quochuymao/project232/docs/stm32f103c8t6_development_kit__3_.jpg

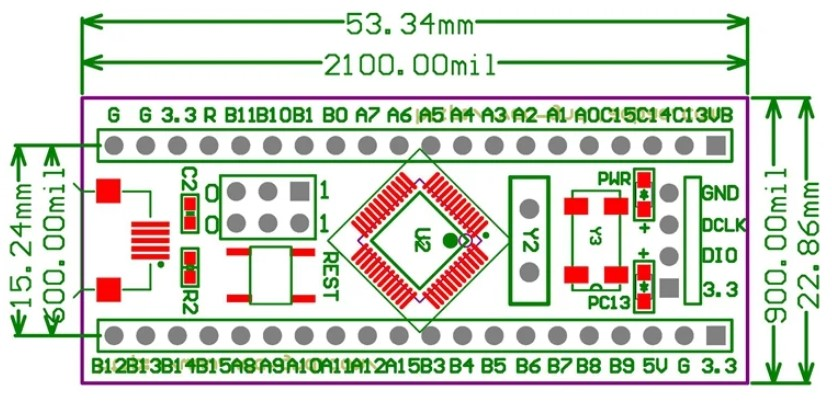
docs/stm32f103c8t6_development_kit__3_.jpg
