quochuymao/project232/project_rfs/MPPT 10A/IMG PCB.JPG

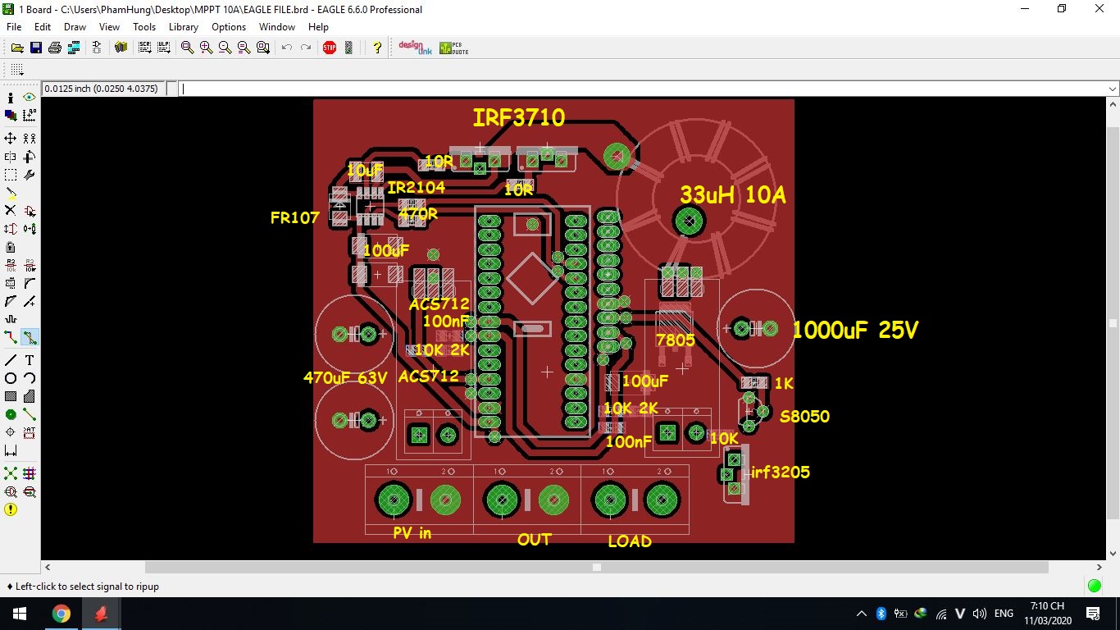
project_rfs/MPPT 10A/IMG PCB.JPG
