quochuymao/project232/project_rfs/firmware docs and API/fucntion.docx

Đọc ADC

ADC_Vi >= 17.6V → Buck_EN

ADC_Vi < 17.6 → Buck_DIS

Từ ADC_Vo và ADC_Io → P_out

Từ ADC_Vi và ADC_Ii → P_in

P_out và P_in lên LCD

LCD:

Dòng 1: Pout = Pin =

Dòng 2: Bat: (CH or NCH) LOAD: ( ON or OFF)

Duty_cycle ++ để thay đổi P_out →

So sánh P_out hiện tại với P_out trước → Lấy cái lớn hơn

ADC_Vo >11.5V → LOAD_EN

ADC_Vo < 11.5V → LOAD_DIS
