quochuymao/project232/docs/thamkhao.pdf

BỘ CÔNG THƯƠNG
TRƯỜNG ĐẠI HỌC KINH TÊ - KỸ THUẬT CÔNG NGHIỆP KHOA ĐIỆN

ĐỒ ÁN 2
THIẾT KẾ BỘ BIẾN ĐỔI DC-DC BUCK ĐỂ NẠP ACQIU TỪ PANEL PV

TÊN ĐỀ TÀI:

(Thiết kế bộ biến đổi DC-DC BUCK để nạp acqui từ PANEL PV)

Ngành đào tạo: Công nghệ kỹ thuật Điện – Điện tử

Họ và tên sinh viên: Nguyễn Cao Kỳ Lớp : D10A1 – HN
MSSV : 16104100052

Người hướng dẫn :

Hà Nội - 2019

ĐT-LVTN-02

NHẬN XÉT CỦA GIÁO VIÊN HƯỚNG DẪN

Hà Nội, Ngày …. Tháng …. Năm 2018

NHẬN XÉT CỦA GIÁO VIÊN DUYỆT

Hà Nội, Ngày …. Tháng …. Năm 2018

CHƯƠNG 1
Tổng quan về bộ biến đổi 1 chiều DC-DC
1) Tổng quan về về bộ biến đổi 1 chiều dc-dc
Ngày nay, các bộ biến đổi sử dụng trong các hệ thống rất thông dụng bởi hiệu suất va chất lượng điện áp. Các bộ biến đổi điện áp một chiều là một trong những bộ biến đổi được sử dụng nhiều nhất. Trong đó, bộ biến đổi giảm áp (Buck Converter) sẽ cho điện áp đầu ra giảm đi so với điện áp đầu vào. Nó được ứng dụng rộng rãi trong nhiều thiết bị hay hệ thống khác nhau như: cấp nguồn cho máy tính và laptop, các bộ sạc điện thoại, nạp pin từ năng lượng mặt trời… Như chúng ta đã biết thì nguồn điện là một phần rất quan trọng đối với một mạch điện hay một hệ thống điện nào đó. Nguồn điện ảnh hưởng trực tiếp đến hoạt động của mạch hay hệ thống. Đối với mỗi mạch điện hay hệ thống nó cần đòi hỏi các nguồn đầu vào khác nhau từ một nguồn đầu vào cố định hay có sẵn. Nguồn DC được sử dụng rất rộng rãi và được sử dụng hầu hết trong các mạch điện hay các hệ thống điện. Nhưng để sử dụng nguồn DC vào hệ thống của mình thì nguồn DC này cần phải được biến đổi thành nguồn DC khác hay nhiều nguồn DC cung cấp cho hệ thống. Ví dụ như mình có 1 nguồn đầu vào là 12V mà hệ thống của mình nó chạy tới 100V thì lúc này chúng ta phải biến đổi điện áp từ 12V lên 100V để chạy được hệ thống của chúng ta.
Hiện nay thì nguồn xung hay nói cách khác nó là các bộ nguồn biến đổi DC-DC nó được sử dụng phổ biến hầu hết trên các mạch điện và các hệ thống điện tự động. Với ưu điểm là khả năng cho hiệu suất đầu ra cao, tổn hao thấp, ổn định được điện áp đầu ra khi đầu vào thay đổi, cho nhiều đầu ra khi với một đầu vào....Nguồn xung hiện nay có rất nhiều loại khác nhau nhưng nó được chia thành 2 nhóm nguồn : Cách ly và không cách ly
* Nhóm nguồn không cách ly :
+ Boot
+ Buck
+ Buck - Boot
* Nhóm nguồn cách ly :
+ flyback
+ Forward
+ Push-pull

+ Half Bridge
+ .......
Mỗi loại nguồn trên đều có những ưu nhược điểm khác nhau. Nên tùy theo yêu cầu của nguồn mà ta chọn các kiểu nguồn xung như trên. Sau đây là nguyên tắc hoạt động của từng bộ nguồn trên mình chỉ nói về các bộ nguồn hay dùng trong thực tế :

### 1.1 Nguồn xung kiểu : Buck

Đây là kiểu biến đổi nguồn cho điện áp đầu ra nhỏ hơn so với điện áp đầu vào tức là Vinout
Xét một mạch nguyên lý sau :

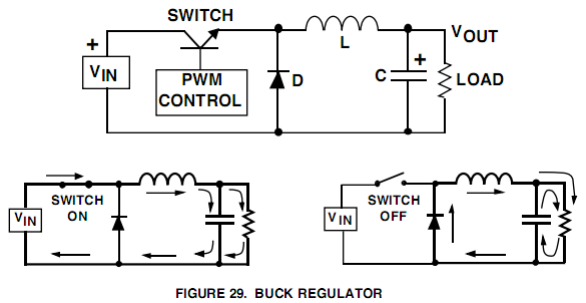
[picture p19: figure]

Mạch có cấu tạo nguyên lý đơn giản chỉ dùng một van đóng cắt nguồn điện và phần lọc đầu ra. Điện áp đầu ra được điều biến theo độ rộng xung
Khi " Switch On" được đóng tức là nối nguồn vào mạch thì lúc đó dòng điện đi qua cuộn cảm và dòng điện trong cuộn cảm tăng lên, tại thời điểm này thì tụ điện được nạp đồng thời cũng cung cấp dòng điện qua tải. Chiều dòng điện được chạy theo hình vẽ Khi " Swith Off" được mở ra tức là ngắt nguồn ra khỏi mạch. Khi đó trong cuộn cảm tích lũy năng lượng từ trường và tụ điện điện được tích lũy trước đó sẽ phóng qua tải. Cuộn cảm có xu hướng giữ cho dòng điện không đổi và giảm dần. Chiều của dòng điện trong thời điểm này như trên hình vẽ.
Quá trình đóng cắt liên tục tạo tải một điện áp trung bình theo luật băm xung PWM. Dòng điện qua tải sẽ ở dạng xung tam giác đảm bảo cho dòng liên tục qua tải. Tần số đóng cắt khá cao để đảm bảo triệt nhiễu công suất cho mạch. Van công suất thường sử dụng các van như Transitor tốc độ cao, Mosfet hay IGBT... Điện áp đầu ra đuoẹc tính như sau:

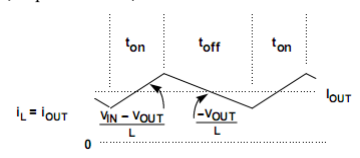
[picture p20: figure]

Vout = Vin * (ton/(ton+toff) = Vin* D ( với D là độ rộng xung %)
Với ton, toff lần lượt là thời gian mở và thời gian khóa của van
Đối với kiểu nguồn Buck này thì cho công suất đầu ra rất lớn so với công suất đầu vào vì sử dụng cuộn cảm, tổn hao công suất thấp. Do vậy nên nguồn buck được sử dụng nhiều trong các mạch giảm áp nguồn DC. ví dụ như từ điện áp 17V DC mà muốn hạ xuống 12V DC thì dùng nguồn Buck là hợp lý.

### 1.2 Nguồn xung kiểu : Boot

Kiểu dạng nguồn xung này cho điện áp đầu ra lớn hơn điện áp đầu vào : Vin < Vout
Xét một mạch nguyên lý như sau :

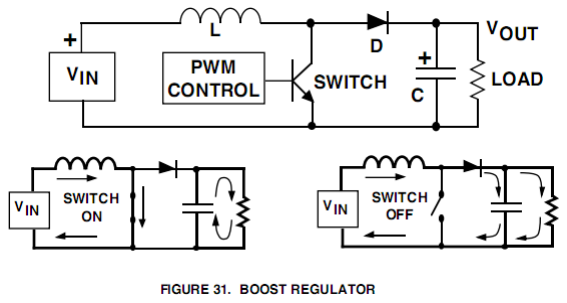
[picture p21: figure]

Mạch có cấu tạo nguyên lý khá đơn giản. Cũng dùng một nguồn đóng cắt, dùng cuộn cảm và tụ điện. Điện áp đầu ra phụ thuộc vào điều biến độ rộng xung và giá trị cuộn cảm L

Khi “Swich On” được đóng lại thì dòng điện trong cuộn cảm được tăng lên rất nhanh, dòng điện sẽ qua cuộn cảm qua van và xuống đất. Dòng điện không qua diode và tụ điện phóng điện cung cấp cho tải. Ở thời điểm này thì tải được cung cấp bởi tụ điện. Chiều của dòng điện như trên hình vẽ
Khi “Switch Off” được mở ra thì lúc này ở cuối cuộn dây xuất hiện với 1 điện áp bằng điện áp đầu vào. Điện áp đầu vào cùng với điện áp ở cuộn cảm qua diode cấp cho tải và đồng thời nạp cho tụ điện. Khi đó điện áp đầu ra sẽ lớn hơn điện áp đầu vào, dòng qua tải được cấp bởi điện áp đầu vào. Chiều của dòng điện được đi như hình vẽ!

Điện áp ra tải còn phụ thuộc giá trị của cuộn cảm tích lũy năng lượng và điều biến độ rộng xung (điều khiển thời gian on/off). Tần số đóng cắt van là khá cao hàng Khz để triệt nhiễu công suất và tăng công suất đầu ra.Dòng qua van đóng cắt nhỏ hơn dòng đầu ra.Van công suất thường là Transior tốc độ cao, Mosfet hay IGBT… Diode là diode xung, công suất
Công thức tính các thông số đầu ra của nguồn Boot như sau :

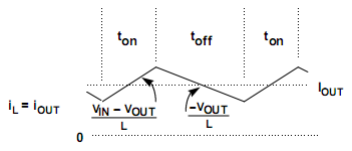
[picture p22: figure]

Ipk = 2 x Iout,max x (Vout / Vin,min) Tdon = (L x Ipk) / (Vout – Vin)
Điện áp đầu ra được tính như sau :

Vout = ((Ton / Tdon) + 1) x Vin
Với : Ton là thời gian mở của Van
Ipk là dòng điện đỉnh
Trong nguồn Boot thì điện áp đầu ra lớn hơn so với điện áp đầu vào do đó công suất đầu vào phải lớn hơn so vói công suất đầu ra. Công suất đầu ra phụ thuộc vào cuộn cảm L.Hiệu suất của nguồn Boot cũng khá cao nên được dùng nhiều trong các mạch nâng áp do nó truyền trực tiếp nên công suất của nó rất lớn. Ví dụ như mạch biến đổi từ nguồn 12VDC lên 310VDC chả hạn.
Nguồn Boot có 2 chế độ:

– Chế độ không liên tục: Nếu điện cảm của cuộn cảm quá nhỏ, thì trong một chu kỳ đóng cắt, dòng điện sẽ tăng dần nạp năng lượng cho điện cảm rồi giảm dần, phóng năng lượng từ điện cảm sang tải. Vì điện cảm nhỏ nên năng lượng trong điện cảm cũng nhỏ, nên hết một chu kỳ, thì năng lượng trong điện cảm cũng giảm đến 0. Tức là trong một chu kỳ dòng điện sẽ tăng từ 0 đễn max rồi giảm về 0.
– Chế độ liên tục: Nếu điện cảm rất lớn, thì dòng điện trong 1 chu kỳ điện cảm sẽ không thay đổi nhiều mà chỉ dao động quanh giá trị trung bình.Chế độ liên tục có hiệu suất và chất lượng bộ nguồn tốt hơn nhiều chế độ không liên tục, nhưng đòi hỏi cuộn cảm có giá trị lớn hơn nhiều lần.

### 1.3 NGUỒN XUNG KIỂU FLYBACK

Đây là kiểu nguồn xung truyền công suất dán tiếp thông qua biến áp. Cho điện áp đầu ra lớn hơn hay nhỏ hơn điện áp đầu vào. Từ một đầu vào có thể cho nhiều điện áp đầu ra
Sơ đồ nguyên lý như sau :

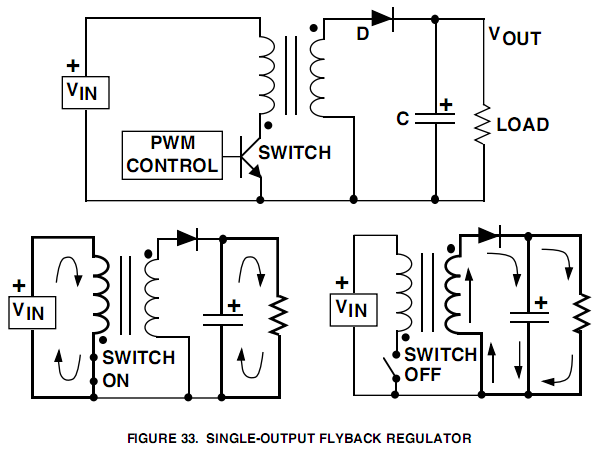
[picture p23: figure]

Mạch có cấu tạo bởi 1 van đóng cắt và 1 biến áp xung. Biến áp dùng để truyền công suất từ đầu vào cho đầu ra. Điện áp đầu ra phụ thuộc vào băm xung PWM và tỉ số truyền của lõi

Như chúng ta đã biết chỉ có dòng điện biến thiên mới tạo được ra từ thông và tạo được ra sức điện động cảm ứng trên các cuộn dây trên biến áp. Do đây là điện áp một chiều nên dòng điện không biến thiên theo thời gian do đó ta phải dùng van đóng cắt liên tục để tạo ra được từ thông biến thiên.
Khi “Switch on ” được đóng thì dòng điện trong cuộn dây sơ cấp tăng dần lên. Cực tính của cuộn dây sơ cấp có chiều như hình vẽ và khi đó bên cuộn dây thứ cấp sinh ra một điện áp có cực tính dương như hình vẽ. Điện áp ở sơ cấp phụ thuộc bởi tỷ số giữa cuộn dây sơ cấp và thứ cấp. Lúc này do diode chặn nên tải được cung cấp bởi tụ C
Khi “Switch Off” được mở ra. Cuộn dây sơ cấp mất điện đột ngột lúc đó bên thứ cấp đảo chiều điện áp qua Diode cung cấp cho tải và đồng thời nạp điện cho tụ
Trong các mô hình của nguồn xung thì nguồn Flybach được sử dụng nhiều nhất bởi tính linh hoạt của nó, cho phép thiết kế được nhiều nguồn đầu ra với 1 nguồn đầu vào duy nhất kể cả đảo chiều cực tính. Các bộ biến đổi kiểu Flyback được sử dụng rộng rãi trong các hệ thống sử dụng nguồn pin hoặc acqui, có một nguồn điện áp vào duy nhất để cung cấp cho hệ thống cần nhiều cấp điện áp(+5V,+12V,-12V) với hiệu suất chuyển đổi cao.Đặc điểm quan trọng của bộ biến đổi Flyback là pha(cực tính) của biến áp xung được biểu diễn bởi các dấu chấm trên các cuộn sơ cấp và thứ cấp (trên hình vẽ)
Công thức tính toán cho nguồn dùng Flyback

Vout=Vin x (n2/n1) x (Ton x f) x (1/(1-(Ton x f)))
với :
- n2 = cuộn dây thứ cấp của biến áp
- n1 = Cuộn dây sơ cấp biến áp
- Ton = thời gian mở của Q1 trong 1 chu kì
- f là tần số băm xung (T=1/f = (Ton + Toff))
Nguồn xung kiểu Flyback hoạt động ở 2 chế độ : Chế độ liên tục (dòng qua thứ cấp luôn > 0) và chế độ gián đoạn (dòng qua thức cấp luôn bằng 0)

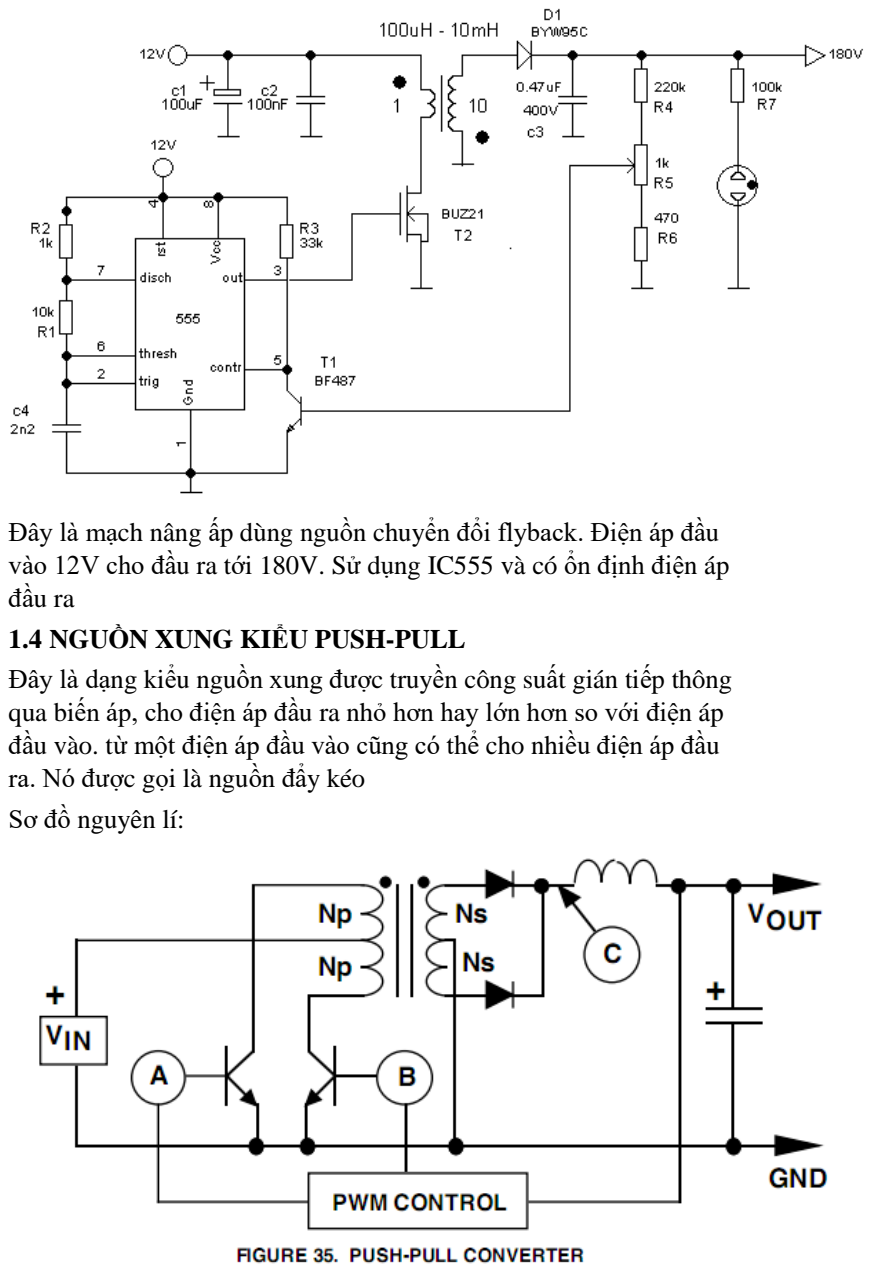
[picture p24: page 10]

Đây là mạch nâng ấp dùng nguồn chuyển đổi flyback. Điện áp đầu vào 12V cho đầu ra tới 180V. Sử dụng IC555 và có ổn định điện áp đầu ra

### 1.4 NGUỒN XUNG KIỂU PUSH-PULL

Đây là dạng kiểu nguồn xung được truyền công suất gián tiếp thông qua biến áp, cho điện áp đầu ra nhỏ hơn hay lớn hơn so với điện áp đầu vào. từ một điện áp đầu vào cũng có thể cho nhiều điện áp đầu ra. Nó được gọi là nguồn đẩy kéo
Sơ đồ nguyên lí:

Đối với nguồn xung loại Push-Pull này thì dùng tới 2 van để đóng cắt biến áp xung và mỗi van dẫn trong 1 nửa chu kì. Nguyên tắc cũng gần giống với nguồn flyback
Khi A được mở B đóng thì cuộn dây Np ở phía trên sơ cấp có điện đồng thời cảm ứng sang cuộn dây Ns phía trên ở thứ cấp có điện và điện áp sinh ra có cùng cực tính. Dòng điện bên thứ cấp qua Diode cấp cho tải. Như trên hình vẽ
Khi B mở và A đóng thì cuộn dây Np ở phía dưới sơ cấp có điện đồng thời cảm ứng sang cuộn dây Ns phía dưới thứ cấp có điện và điện áp này sinh ra cũng cùng cực tính. Như trên hình vẽ.
Với việc đóng cắt liên tục hai van này thì luôn luôn xuất hiện dòng điện liên tục trên tải. Chính vì ưu điểm này mà nguồn Push Pull cho hiệu suất biến đổi là cao nhất và được dùng nhiều trong các bộ nguồn như UPS, Inverter…
Công thức tính cho nguồn Push-pull

Vout = (Vin/2) x (n2/n1) x f x (Ton,A + Ton,B)
Với :
- Vout=Điện áp đầu ra -V
- Vin= Điện áp đầu vào – Volts
- n2=0.5 x cuộn dây thứ cấp. Tức là cuộn dây thứ cấp sẽ quấn sau đó chia 1/2. Đợn vị tính bằng Vòng
- n1=Cuộn dây sơ cấp
- f = Tần số đóng cắt – Hertz
- Ton,A = thời gian mở Van A – Seconds
- Ton,B = Thời gian mở Van B – Seconds

CHƯƠNG 2: CHỌN VÀ PHÂN TÍCH MẠCH LỰC

2) Cấu trúc mạch lực:

Cấu trúc vòng điều khiển điện áp của mạch có dạng chung như sau:

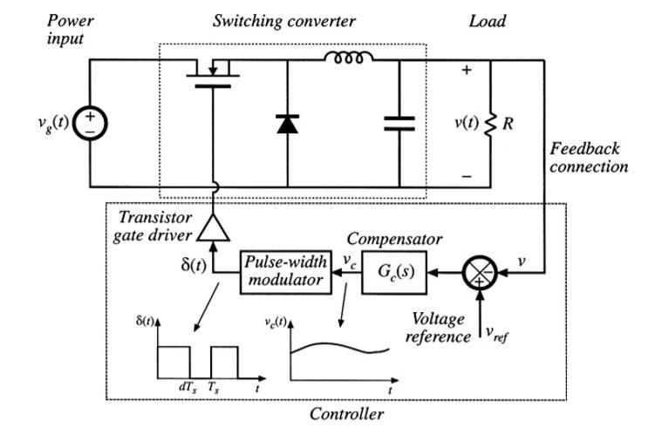
[picture p25: figure]

2.1) Tính toán các thông số cơ bản: Các yêu cầu thiết kế:
- Vin = 17 V
- Vout = 12V
- ILoad = 2A
- fsw= 100kHz ( tần số chuyển mạch)
- Iripple = 0.3 × IL
1. Trình bày cấu trúc mạch lực và nguyên tắc phát xung điều khiển.
2. Tính chọn giá trị danh định và lựa chọn cụ thể (nhà SX, mã sản phẩm) tất cả các phần tử trong mạch: Van bán dẫn, tụ điện, điện cảm,… theo các thông số kỹ thuật yêu cầu.
3. Xây dựng chương trình mô phỏng bộ biến đổi kiểm chứng thiết kế.
2.1.1.Tính toán cuộn cảm L

Khi van ở trạng thái ON thì diện áp trên ahi đầu cuộn cảm bằng [1]: vL(t) = Vg - v(t)
Hay gần đúng sẽ là:
vL(t) = Vg – V | (2.2)
Trong đó vL tính theo công thức:
vL = LdiL(t) dt | (2.3)

Từ đó ta được:
diL(t)
dt

=

vL(t)
L

≈

Vg−V
L

(2.4)

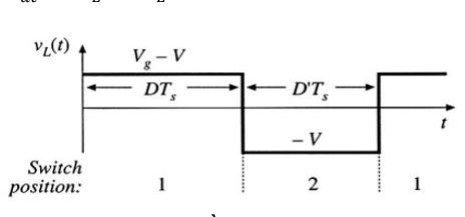
[picture p26: figure]

Hình 2.2 Đồ thị điện áp trên cuộn cảm theo thời gian

Khi van ở trạng thái mở thì điện áp cuộn cảm bằng: vL

(t) = −v(t) | (2.5)
Với v(t) ≈ V thì:
vL
(t) = −V | (2.6)
Suy ra :
diL(t)
dt

= −

V L | (2.7)

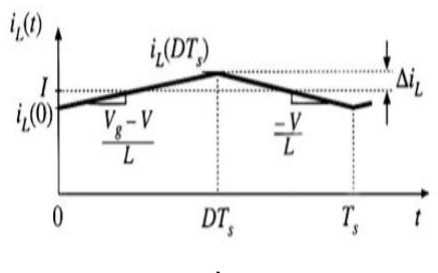
[picture p27: figure]

Hình 2.3 Đồ thị dòng điện qua cuộn cảm theo thời gian

Dòng điện qua cuộn cảm được miêu tả như Hình 2.3, ta có thể thấy

dòng điện Ipeak = I + ∆iL

, trong đó ∆iL
là độ gợn (độ dao động)
của dòng điện qua cuộn cảm.
Nên độ gợn peak-to-peak sẽ là 2∆iL và bằng : 2∆iL =

Vg−V
L

DTs
(2.8)
Suy ra:

L = Vg−V
2∆iL

DTs
(2.9)
Với giá trị ∆iL

thường được chọn khoảng 10 ÷ 20%Iout. Ta chọn: ∆iL = 10%Iout = 0,2A Hệ số đóng cắt của van đóng cắt: D = V
Vg

=

12
17
= 0,7 | (2.10)
Thay các thông số từ yêu cầu vào L = Vg−V
2∆iL

DTs
(2.9), ta tính được

giá tri cuộn cảm như sau:
L = Vg−V
2∆iL

DTs =

17−12
2.0,2.100.10³
.0,7 = 87µF | (2.11)

### 2.1.2 Tính toán tụ C đầu ra

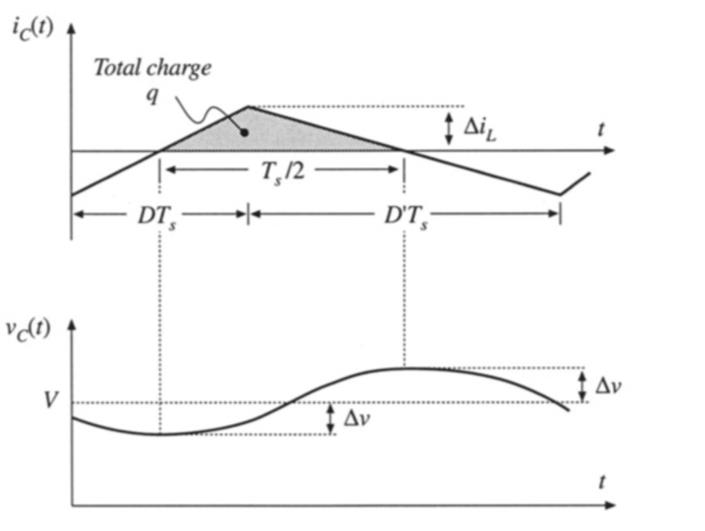
[picture p28: figure]

Hình 2.4 Dòng điện và điện áp trên tụ [6]

a) Tính toán giá trị điện dung C của tụ điện Lượng điện tích trong tụ được tính theo công thức [1]:
(change in charge) = C. (change in voltage) (2.12)
Hinh 2.4 mô tả hình dạng dòng điện và điện áp trên tụ, từ đó ta có:

q = C(2∆v) | (2.13)
hay:

q =

1
2

V. ∆iL

Ts
2

(2.14)

Từ q = C(2∆v) (2.13) hay: q =

1
2

V. ∆iL

Ts
2

(2.14), ta được:

∆v =

∆iL.Ts
8C

(2.15)

Suy ra :

C = ∆iL.Ts
8∆v

(2.16)

Chọn độ dao động điện áp: ∆v = 1%V = 1%.12 = 0,12 V Thay các thông số từ yêu cầu vào Suy ra: C = ∆iL.Ts
8∆v

(2.16), ta
tính được giá trị điện dung của tụ điện như sau :

C=∆iL.Ts
8∆v

=

1
8.0.0,12.100.10³

≈ 10uF

Chọn tụ điện theo catologe của nhà sản xuất: C = 4700 µF (chọn theo kinh nghiệm)
a) Tính toán điện trở RESR của tụ điện
Sau khi tính toán và chọn được tụ điện C, dựa vao datasheet ta có thể xác định được điện trở RESR của tụ điện [2]:

Với fs = 100 khz và RESR0

là điện trở đo tại nhiệt độ 20⁰C ở tần số 100 Hz. Từ đồ thị trên datasheet (hình 2.5), ta có thể xác định được tỉ

số giữa RESR và RESR0
khoảng 0,77.
Tra bảng datasheet (bảng 2.1), ta có RESR0

= 0,10Ω => RESR
≅ 0,0789Ω.

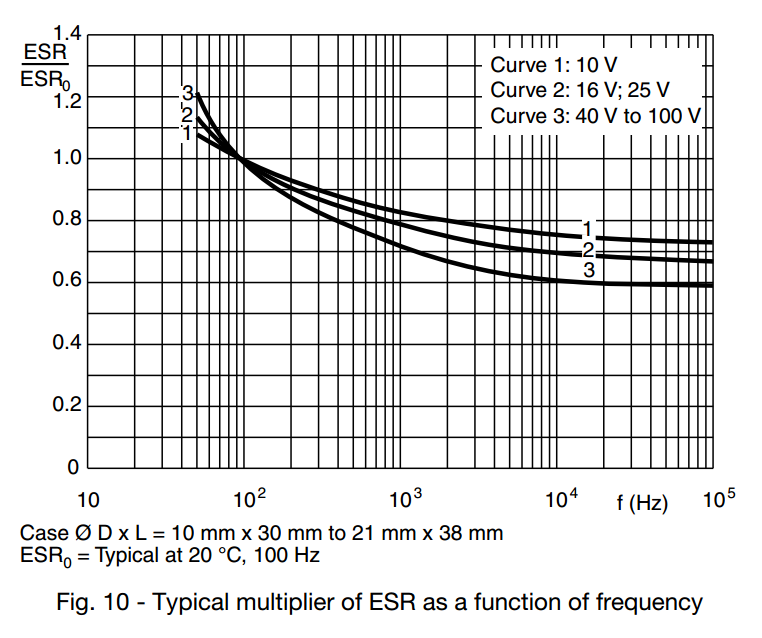
[picture p29: figure]

Hình 2.5 Đồ thị thể hiện mối liên hệ giữa điện trở và tần số của tụ điện C [2]

CR 100 Hz (µF) | NOMIAL CASE SIZE Ø D x L (mm) | CASE CODE | IR 100 Hz 125˚C (mA) | IL1 1 min (µA) | IL5 5 min (µA) | tan δ 100 Hz | ESR 100 Hz (Ω)
100 220 470 470 680 1000 1500 2200 3300 4700 | 6.5 x 18 10 x 18 10 x 25 12.5 x 30 12.5 x 30 15 x 30 18 x 30 18 x 30 18 x 38 21 x 38 | 4 6 7 01 01 02 03 03 04 05 | 130 240 380 550 640 830 1100 1190 1550 1700 | 10 17 32 32 45 64 94 136 202 286 | 6 8.4 13 13 18 24 34 48 70 90 | 0.20 0.18 0.18 0.16 0.20 0.20 0.22 0.26 0.27 0.30 | 3.50 1.30 0.61 0,54 0,47 0.32 0.23 0.19 0.13 0.10

Bảng 2.1 Bảng tra datasheet về tụ điện [2]

2.1.3 . Chọn van bán dẫn

a) Van đóng cắt

chọn van đóng cắt là MOSFET tần số cao . Dòng IL=Iout=1A nên chọn MOSFET Ì540N

có thể chịu đựng dòng tối đa là 33A , điện áp tối đa là 100V.

b) Diode
Chọn loại diode tần số cao Schottky SB540 chịu được dòng 5A và điện áp 40V.

### 2.1.4. Thiết kế cuộn cảm dung phương pháp Kg[1]

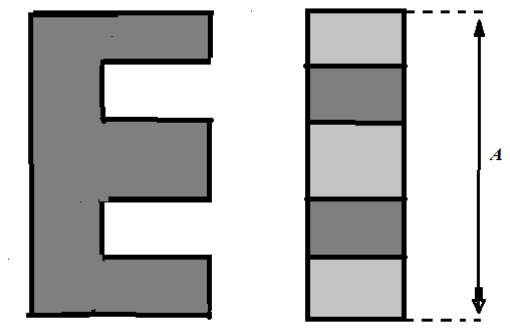
[picture p30: figure]

Hình 2.6 Hình dạng lõi thép của cuộn kháng

Với L = 87µH như đã tính toán ở trên

Tính toán hệ số Kg:

Kg ≥

ρL

2
Imax

2

Bmax

2

. 10⁸

(cm⁵
) | (2.18)

Giả sử :R=1Ω.

Với các thông số : ρ = 1,724.10⁶ (chọn dây đồng)

Imax =2A

Bmax =0,25 T

Ku =0,6

Thay vào Kg ≥

ρL

2
Imax

2

Bmax

2 RKu

. 10⁸
(cm⁵
) (2.18)

Kg ≥

1.724.10⁻⁶

.(56.10⁻⁶
)

2
.2

2
0.25².1.0,6

ta được :Kg≈ 1,39818.10⁻³

Dựa vào Bảng 2.2 Bảng chọn lõi thép , chọn lại giá trị Kg = 1,39818.10⁻³ và

chọn lõi thép EE19 có các thong số như sau:

Diện tích mặt cắt trụ giữa: Ac = 0,19 cm²

Diện tích cửa sổ: WA = 0,19 cm²

Độ dài trung bình 1 vòng dây: MLT =3,4 cm

Hệ số từ thẩm: µ0 = 4π.10⁻⁷ H/m

Bảng 2.2.Bảng chọn lõi thép

Core type

(A)

(mm)

Geometri
cal
constant

Kg

cm⁵

Geometri
cal
constant

Kgfe

cmx

Cross-section
al area

Ac

(cm²
)

Bobbi
n
windi
ng
area

WA

(cm²
)

Mea
n
lengt
h per
turn

MLT

(cm)

Magnet
ic path
length

lm

Core
weig
ht

(g)

EE12

EE16

EE19

EE22

EE30

EE40

EE50

EE60

EE70/68/
19

0.731.10⁻³

2.02.10⁻³

4.07.10⁻³

8.26.10⁻³

85.7.10⁻³

0.209

0.909

1.38

5.06

0.458.10⁻³

0.842.10⁻³

1.3.10⁻³

1.8.10⁻³

6.7.10⁻³

11.8.10⁻³

28.4.10⁻³

36.4.10⁻³

127.10⁻³

0.14

0.19

0.23

0.41

1.09

1.27

2.26

2.47

3.24

0.085

0.190

0.284

0.196

0.476

1.10

1.78

2.89

6.75

2.28

3.40

3.69

3.99

6.60

8.50

10.0

12.8

14.0

2.7

3.45

3.94

3.96

5.77

7.70

9.58

11.0

9.0

2.34

3.29

4.83

8.81

32.4

50.3

116

135

280
