quochuymao/project232/docs/LQFP48.jpg

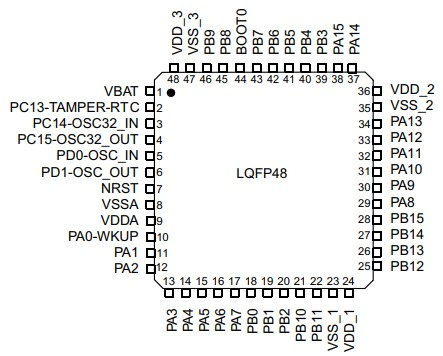
docs/LQFP48.jpg
