quochuymao/project232/project_rfs/MPPT 10A/code-simulation-on-proteus.png

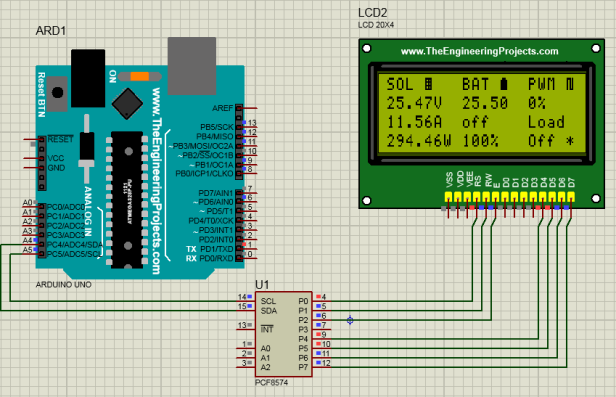
project_rfs/MPPT 10A/code-simulation-on-proteus.png
