quochuymao/project232/project_rfs/MPPT 10A/final.jpg

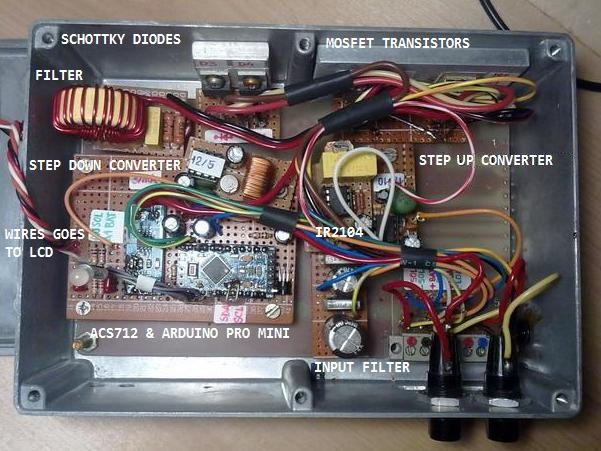
project_rfs/MPPT 10A/final.jpg
