quochuymao/project232/project_rfs/MPPT 10A/microcontrolere.wordpress_files/boost-convertor.jpg

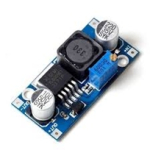
project_rfs/MPPT 10A/microcontrolere.wordpress_files/boost-convertor.jpg
