quochuymao/project232/project_rfs/MPPT 10A/microcontrolere.wordpress_files/half-bridge.jpg

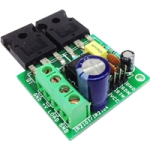
project_rfs/MPPT 10A/microcontrolere.wordpress_files/half-bridge.jpg
