quochuymao/project232/project_rfs/MPPT 10A/microcontrolere.wordpress_files/lcd111.jpg

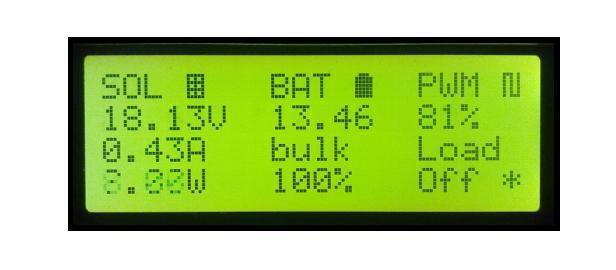
project_rfs/MPPT 10A/microcontrolere.wordpress_files/lcd111.jpg
