quochuymao/project232/project_rfs/MPPT 10A/microcontrolere.wordpress_files/oputput-current-versions.png

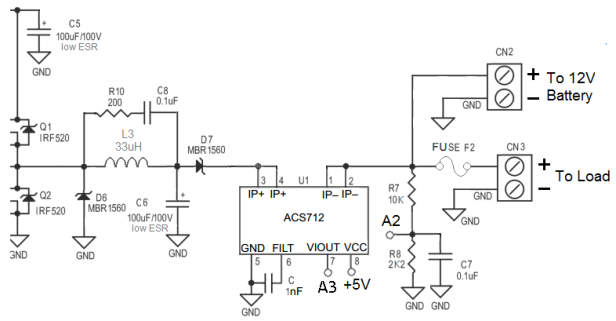
project_rfs/MPPT 10A/microcontrolere.wordpress_files/oputput-current-versions.png
