quochuymao/project232/project_rfs/MPPT 10A/microcontrolere.wordpress_files/oscilloscope.jpg

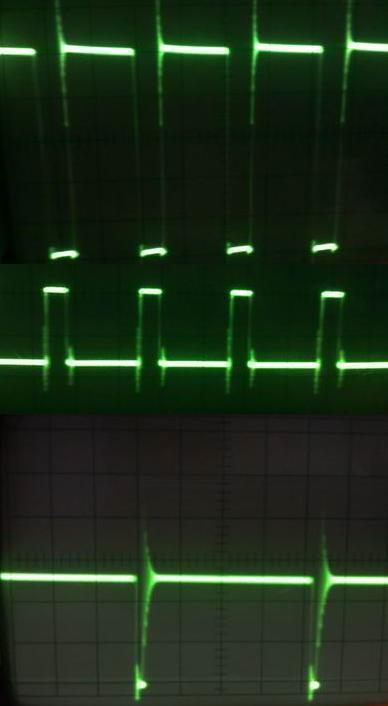
project_rfs/MPPT 10A/microcontrolere.wordpress_files/oscilloscope.jpg
