quochuymao/project232/project_rfs/MPPT 10A/microcontrolere.wordpress_files/schema-3-1.png

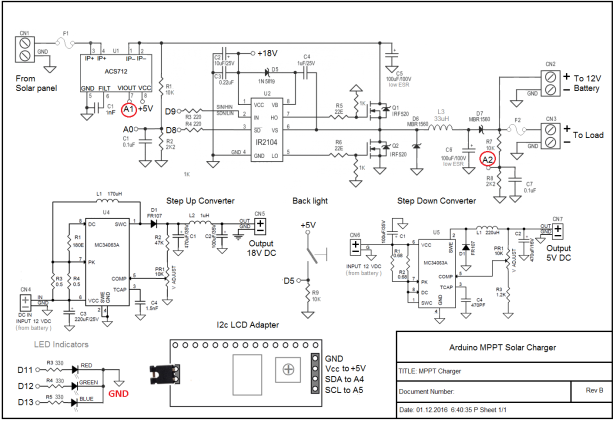
project_rfs/MPPT 10A/microcontrolere.wordpress_files/schema-3-1.png
