quochuymao/project232/project_rfs/MPPT 10A/microcontrolere.wordpress_files/simulation.png

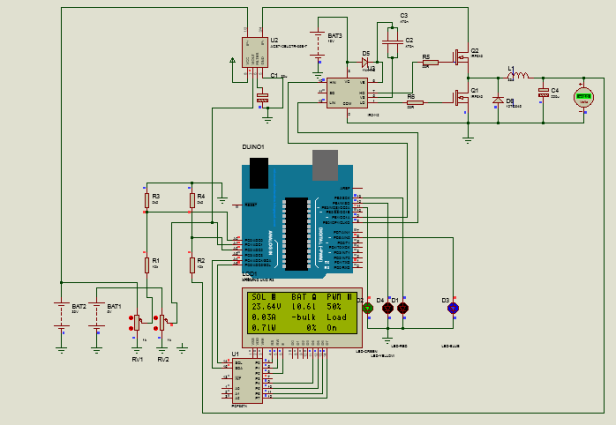
project_rfs/MPPT 10A/microcontrolere.wordpress_files/simulation.png
