quochuymao/project232/project_rfs/MPPT 10A/microcontrolere.wordpress_files/solar-charger-jpg.png

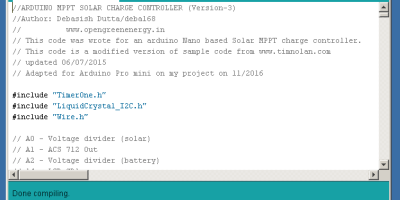
project_rfs/MPPT 10A/microcontrolere.wordpress_files/solar-charger-jpg.png
