quochuymao/project232/project_rfs/MPPT 10A/microcontrolere.wordpress_files/sym.png

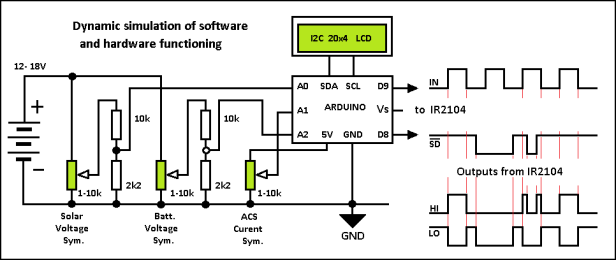
project_rfs/MPPT 10A/microcontrolere.wordpress_files/sym.png
