quochuymao/project232/project_rfs/MPPT 10A/mppt.jpg

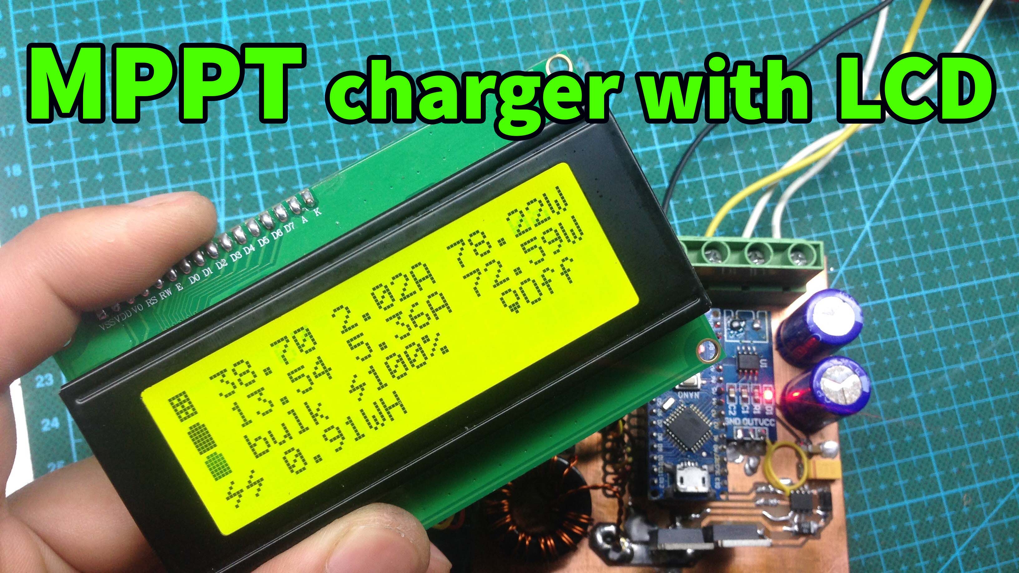
project_rfs/MPPT 10A/mppt.jpg
