quochuymao/project232/project_rfs/MPPT 10A/source.JPG

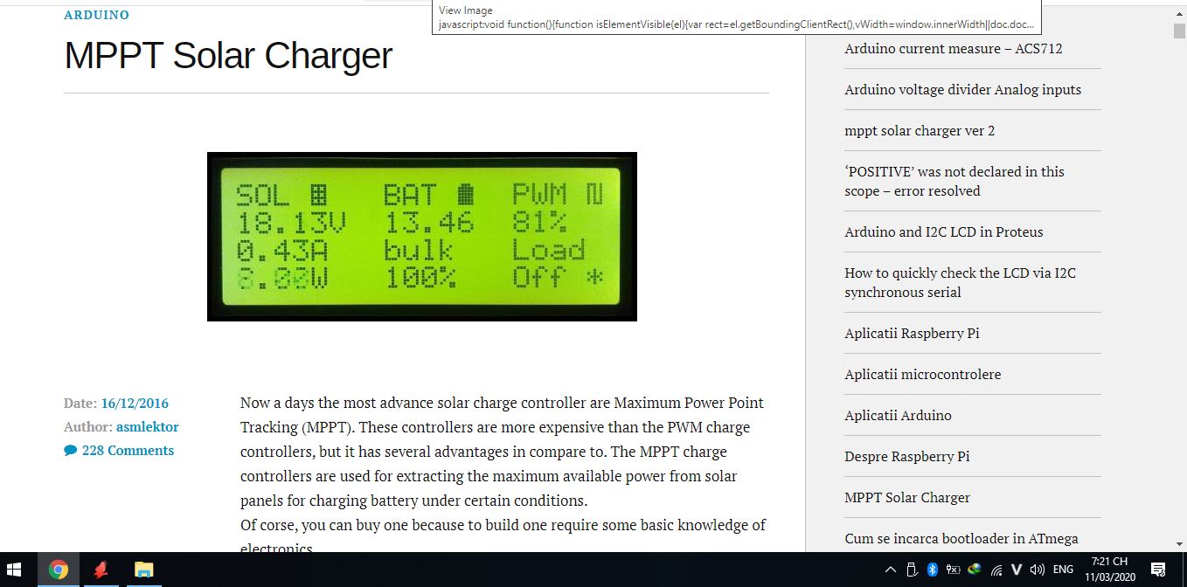
project_rfs/MPPT 10A/source.JPG
