quochuymao/project232/project_rfs/MPPT 10A/Schematic.pdf

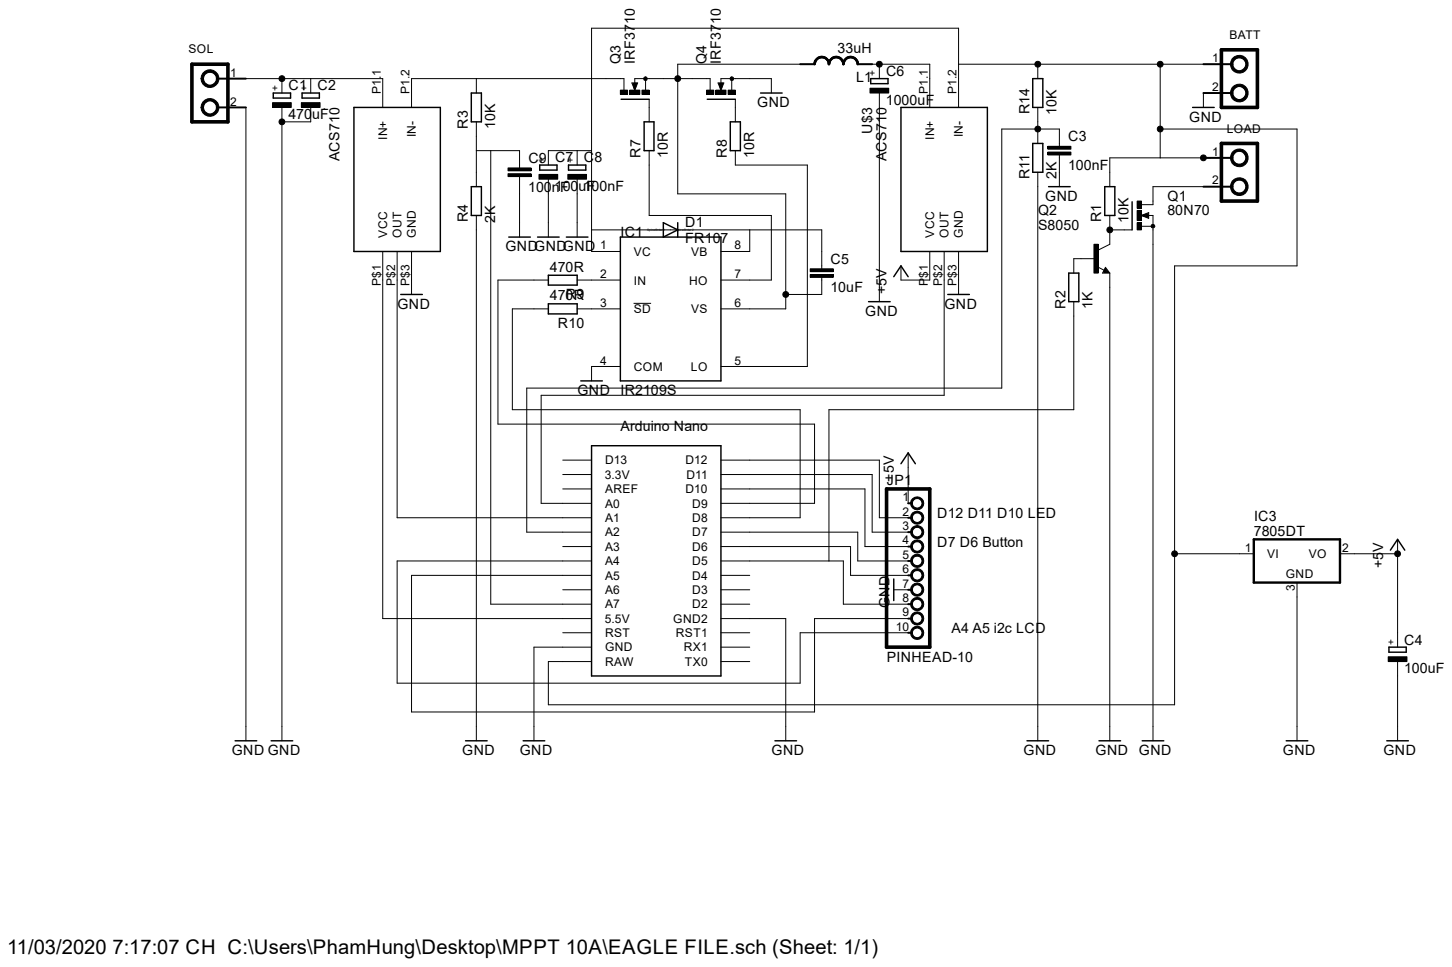
[picture p51: page 1]

11/03/2020 7:17:07 CH C:\Users\PhamHung\Desktop\MPPT 10A\EAGLE FILE.sch (Sheet: 1/1)
