quochuymao/project232/project_rfs/MPPT 10A/File PCB BOTTOM.pdf

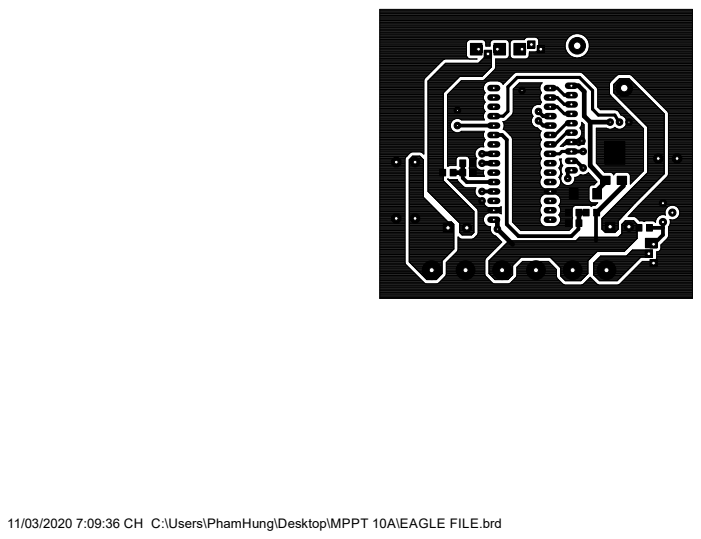
[picture p52: page 1]

11/03/2020 7:09:36 CH C:\Users\PhamHung\Desktop\MPPT 10A\EAGLE FILE.brd
