quochuymao/project232/project_rfs/MPPT 10A/File PCB TOP.pdf

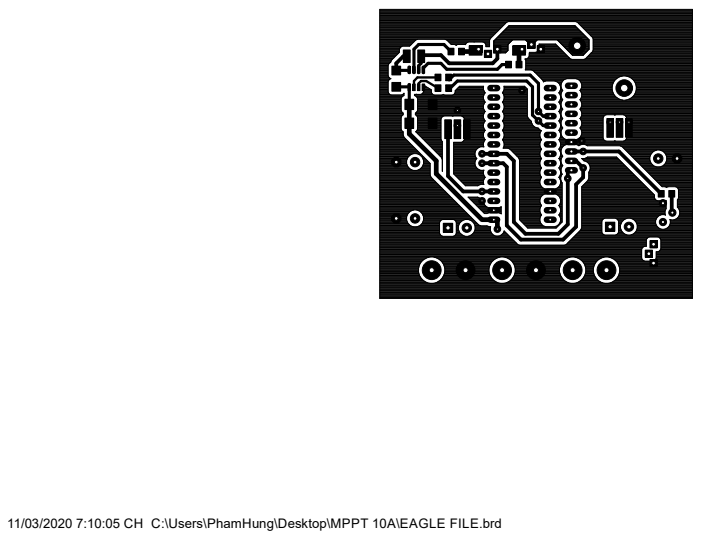
[picture p53: page 1]

11/03/2020 7:10:05 CH C:\Users\PhamHung\Desktop\MPPT 10A\EAGLE FILE.brd
