quochuymao/project232/PCB/Project232_V2/Project232_V2/Project232_V2.kicad_pcb

## KiCad design PCB/Project232_V2/Project232_V2/Project232_V2.kicad_pcb (2024-05-15, an earlier design)

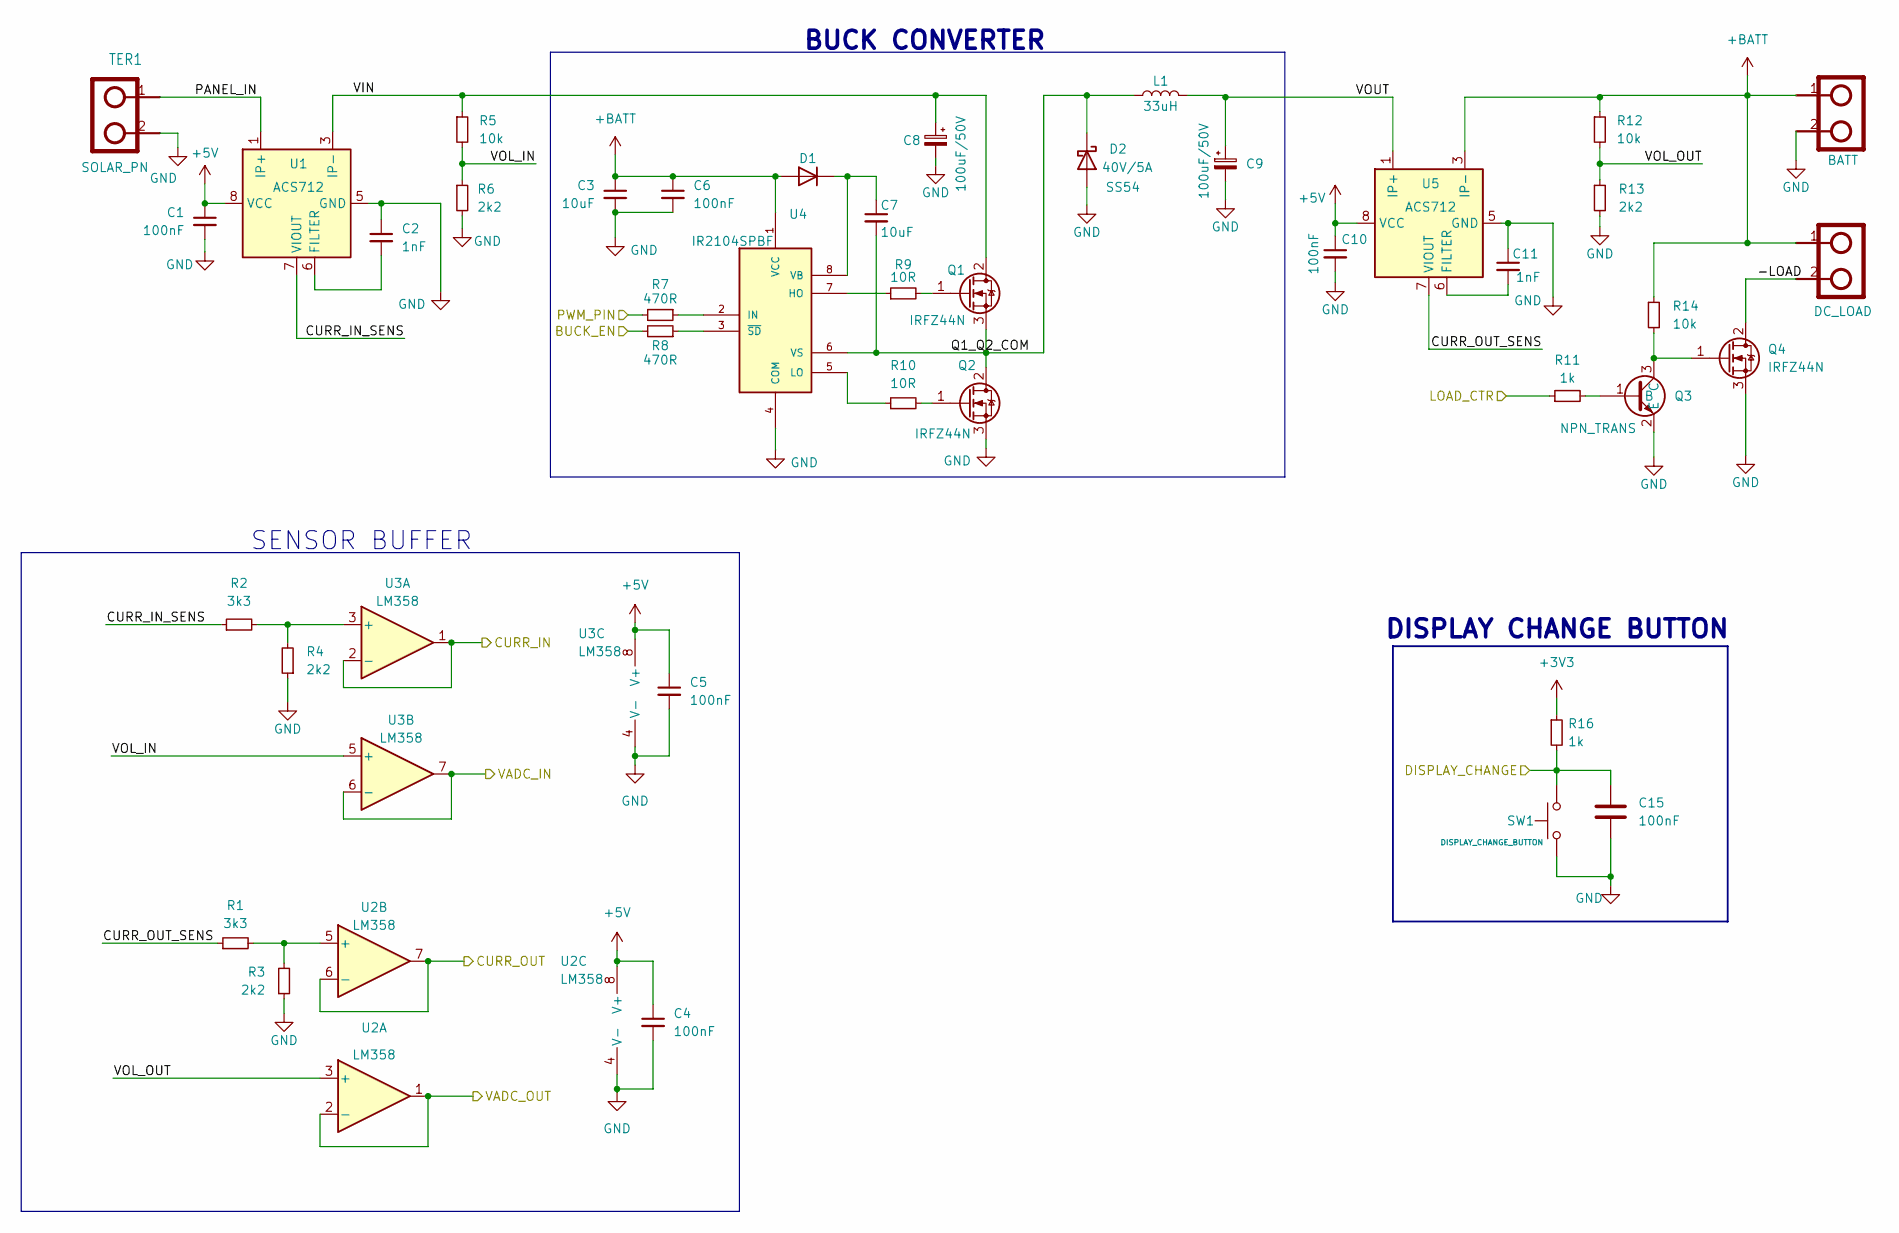
[picture p54: schematic sensor.kicad_sch]

Parts:
C1, C4, C5, C6, C10, C15: 100nF; C_0805_2012Metric
C2, C11: 1nF; C_0805_2012Metric
C3, C7: 10uF; C_0805_2012Metric
C8, C9: 100uF/50V; CP_Elec_8x10.5
D1: 1N5819W; D_SOD-123
D2: 40V/5A; D_SMC
L1: 33uH; Inductor_33uH_5A_THT
Q1, Q2, Q4: IRFZ44N; TO-220-3_Vertical
Q3: NPN_TRANS; SOT-23
R1, R2: 3k3; R_0603_1608Metric
R3, R4, R6, R13: 2k2; R_0603_1608Metric
R5, R12, R14: 10k; R_0603_1608Metric
R7, R8: 470R; R_0603_1608Metric
R9, R10: 10R; R_0603_1608Metric
R11, R16: 1k; R_0603_1608Metric
SW1: DISPLAY_CHANGE_BUTTON; Button_3x6_SMD
TER1: SOLAR_PN; TerminalBlock_bornier-2_P5.08mm
TER2: BATT; TerminalBlock_bornier-2_P5.08mm
TER3: DC_LOAD; TerminalBlock_bornier-2_P5.08mm
U1, U5: ACS712; SOIC-8_3.9x4.9mm_P1.27mm
U2, U3: LM358; SOIC-8_3.9x4.9mm_P1.27mm
U4: IR2104SPBF; SOIC127P600X175-8N; MPN IR2104SPBF

Connections:
+3V3: R16.1; also elsewhere on the board
+5V: C1.1, C4.1, C5.1, C10.1, U1.8 (VCC), U2.8 (V+), U3.8 (V+), U5.8 (VCC); also elsewhere on the board
+BATT: C3.1, C6.1, D1.2 (A), R12.1, R14.1, TER2.1, TER3.1, U4.1 (VCC), U5.3 (IP-), U5.4 (IP-); also elsewhere on the board
/MCU/BUCK_EN: R8.2; also elsewhere on the board
/MCU/CURR_IN: U3.1, U3.2 (-); also elsewhere on the board
/MCU/CURR_OUT: U2.6 (-), U2.7; also elsewhere on the board
/MCU/DISPLAY_CHANGE: C15.1, R16.2, SW1.1; also elsewhere on the board
/MCU/LOAD_CTR: R11.1; also elsewhere on the board
/MCU/PWM_PIN: R7.2; also elsewhere on the board
/MCU/VADC_IN: U3.6 (-), U3.7; also elsewhere on the board
/MCU/VADC_OUT: U2.1, U2.2 (-); also elsewhere on the board
/Sensor/-LOAD: Q4.2 (D), TER3.2
/Sensor/CURR_IN_SENS: R2.1, U1.7 (VIOUT)
/Sensor/CURR_OUT_SENS: R1.1, U5.7 (VIOUT)
/Sensor/PANEL_IN: TER1.1, U1.1 (IP+), U1.2 (IP+)
/Sensor/Q1_Q2_COM: C7.2, D2.1 (K), L1.1, Q1.3 (S), Q2.2 (D), U4.6 (VS)
/Sensor/VIN: C8.1, Q1.2 (D), R5.1, U1.3 (IP-), U1.4 (IP-)
/Sensor/VOL_IN: R5.2, R6.1, U3.5 (+)
/Sensor/VOL_OUT: R12.2, R13.1, U2.3 (+)
/Sensor/VOUT: C9.1, L1.2, U5.1 (IP+), U5.2 (IP+)
GND: C1.2, C2.1, C3.2, C4.2, C5.2, C6.2, C8.2, C9.2, C10.2, C11.1, C15.2, D2.2 (A), Q2.3 (S), Q3.2 (E), Q4.3 (S), R3.1, R4.1, R6.2, R13.2, SW1.2, TER1.2, TER2.2, U1.5 (GND), U2.4 (V-), U3.4 (V-), U4.4 (COM), U5.5 (GND); also elsewhere on the board
unnamed: C7.1, D1.1 (K), U4.8 (VB)
unnamed: Q1.1 (G), R9.2
unnamed: Q2.1 (G), R10.2
unnamed: Q3.1 (B), R11.2
unnamed: Q3.3 (C), Q4.1 (G), R14.2
unnamed: C2.2, U1.6 (FILTER)
unnamed: R1.2, R3.2, U2.5 (+)
unnamed: R2.2, R4.2, U3.3 (+)
unnamed: R9.1, U4.7 (HO)
unnamed: R7.1, U4.2 (IN)
unnamed: R10.1, U4.5 (LO)
unnamed: R8.1, U4.3 (~SD)
unnamed: C11.2, U5.6 (FILTER)

Notes on the sheet:
BUCK CONVERTER
SENSOR BUFFER
DISPLAY CHANGE BUTTON

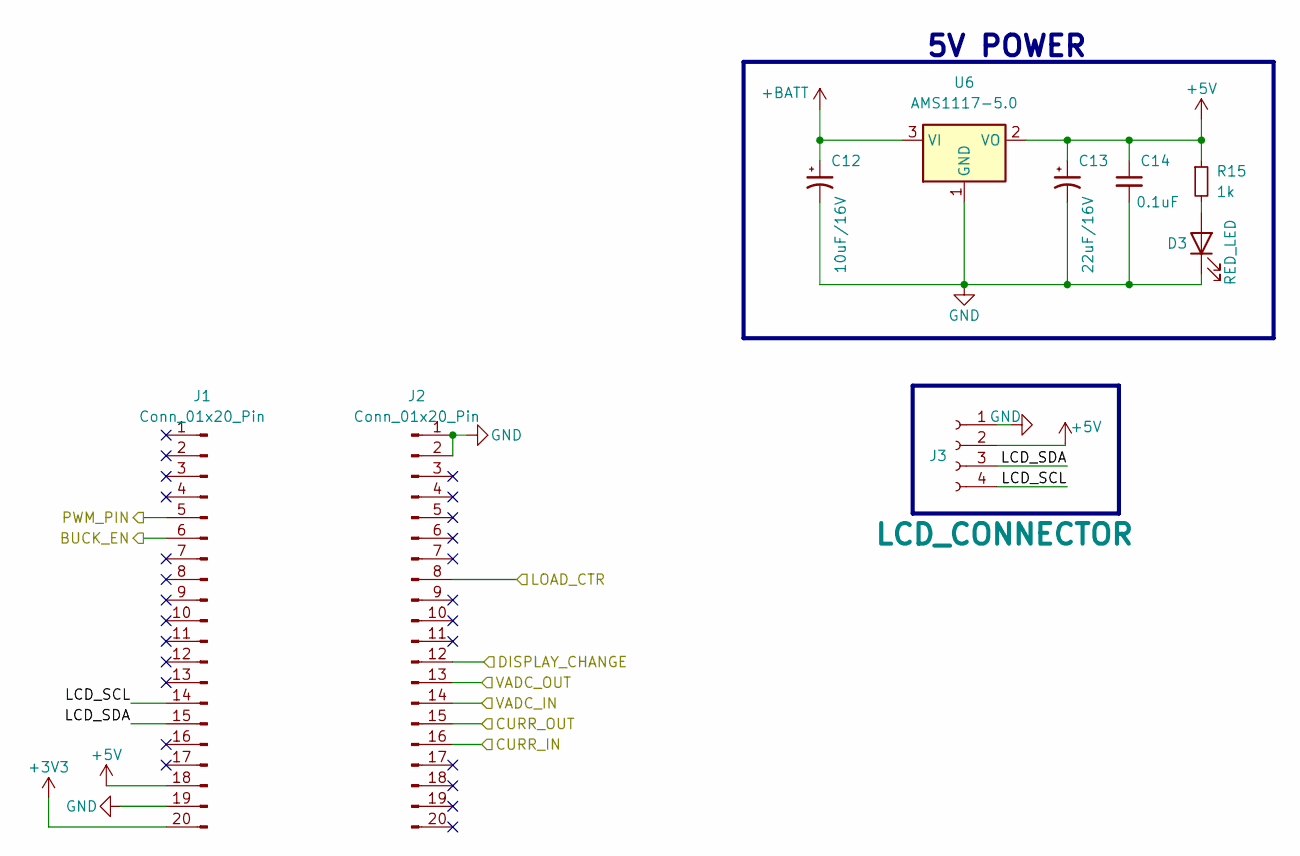
[picture p55: schematic MCU.kicad_sch]

Parts:
C12: 10uF/16V; CP_Elec_4x5.4
C13: 22uF/16V; CP_Elec_4x5.4
C14: 0.1uF; C_0805_2012Metric
D3: RED_LED; LED_0805_2012Metric
J1, J2: Conn_01x20_Pin; PinHeader_1x20_P2.54mm_Vertical
J3: LCD_CONNECTOR; PinHeader_1x04_P2.54mm_Vertical
R15: 1k; R_0603_1608Metric
U6: AMS1117-5.0; SOT-223-3_TabPin2

Connections:
+3V3: J1.20; also elsewhere on the board
+5V: C13.1, C14.1, J1.18, J3.2, R15.1, U6.2 (VO); also elsewhere on the board
+BATT: C12.1, U6.3 (VI); also elsewhere on the board
/MCU/BUCK_EN: J1.6; also elsewhere on the board
/MCU/CURR_IN: J2.16; also elsewhere on the board
/MCU/CURR_OUT: J2.15; also elsewhere on the board
/MCU/DISPLAY_CHANGE: J2.12; also elsewhere on the board
/MCU/LCD_SCL: J1.14, J3.4
/MCU/LCD_SDA: J1.15, J3.3
/MCU/LOAD_CTR: J2.8; also elsewhere on the board
/MCU/PWM_PIN: J1.5; also elsewhere on the board
/MCU/VADC_IN: J2.14; also elsewhere on the board
/MCU/VADC_OUT: J2.13; also elsewhere on the board
GND: C12.2, C13.2, C14.2, D3.1 (K), J1.19, J2.1, J2.2, J3.1, U6.1 (GND); also elsewhere on the board
unnamed: D3.2 (A), R15.2

Notes on the sheet:
5V POWER

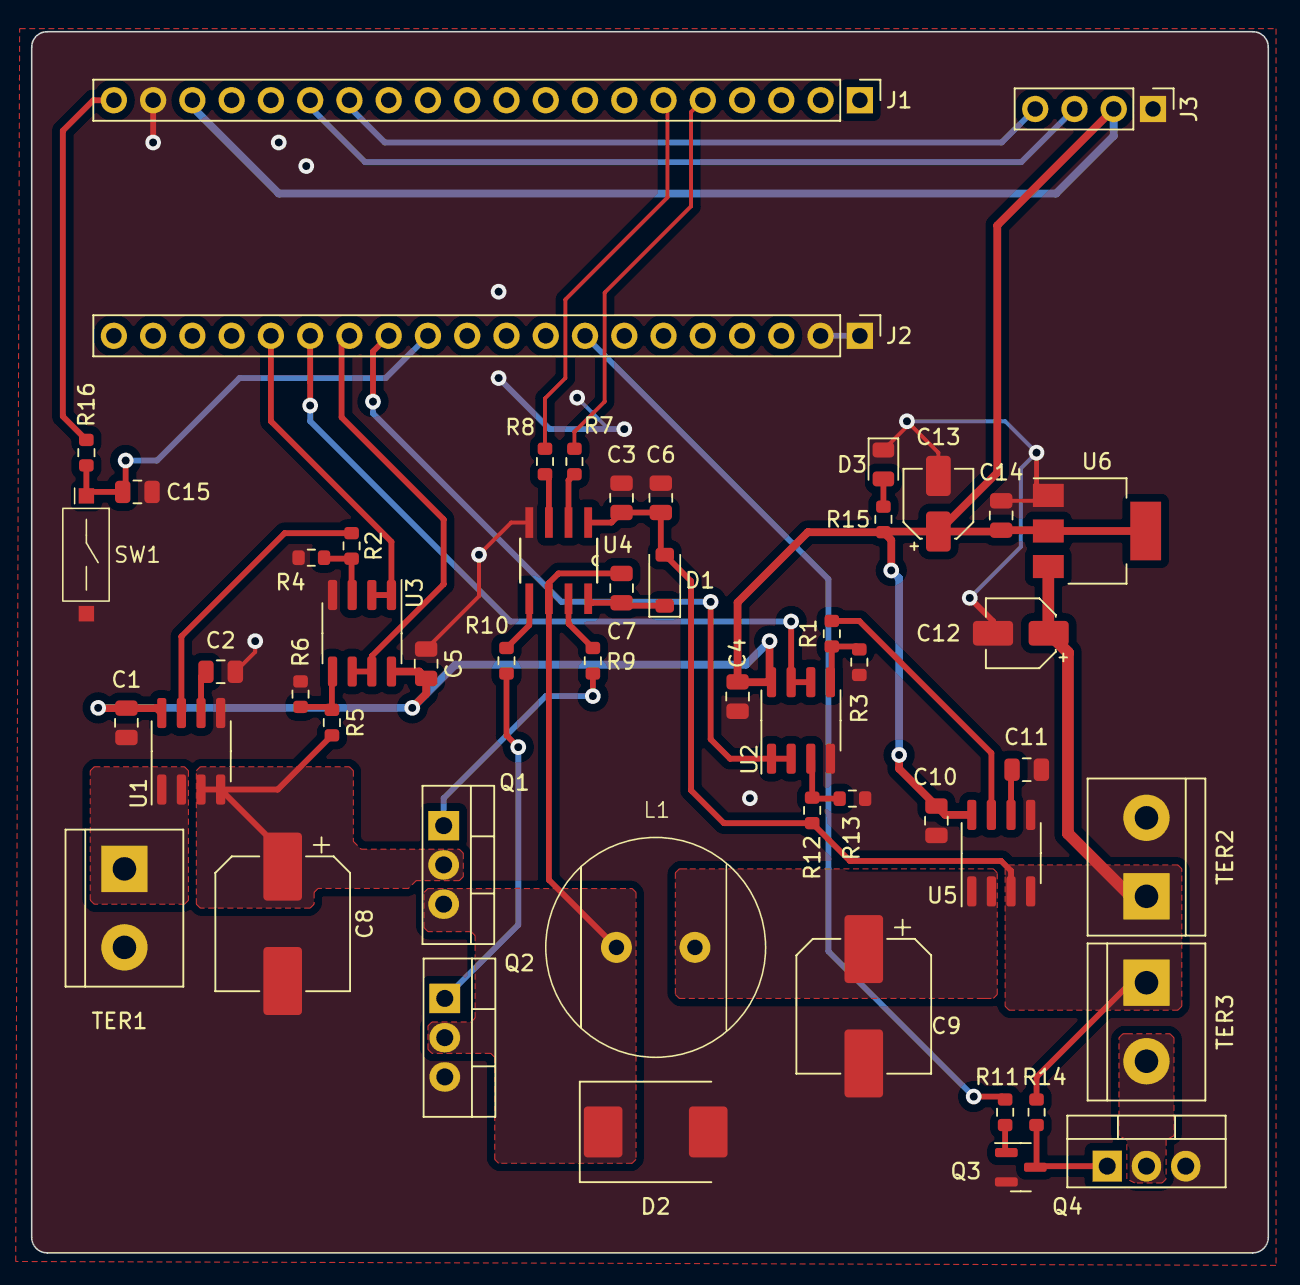
[picture p56: board Project232_V2.kicad_pcb from above]

Board: 2 copper layers, 80.0 x 79.0 mm, 52 parts (0 on the bottom side), 37 nets.
