quochuymao/project232/PCB/Project232/Project232.kicad_pcb

## KiCad design PCB/Project232/Project232.kicad_pcb (2024-05-08)

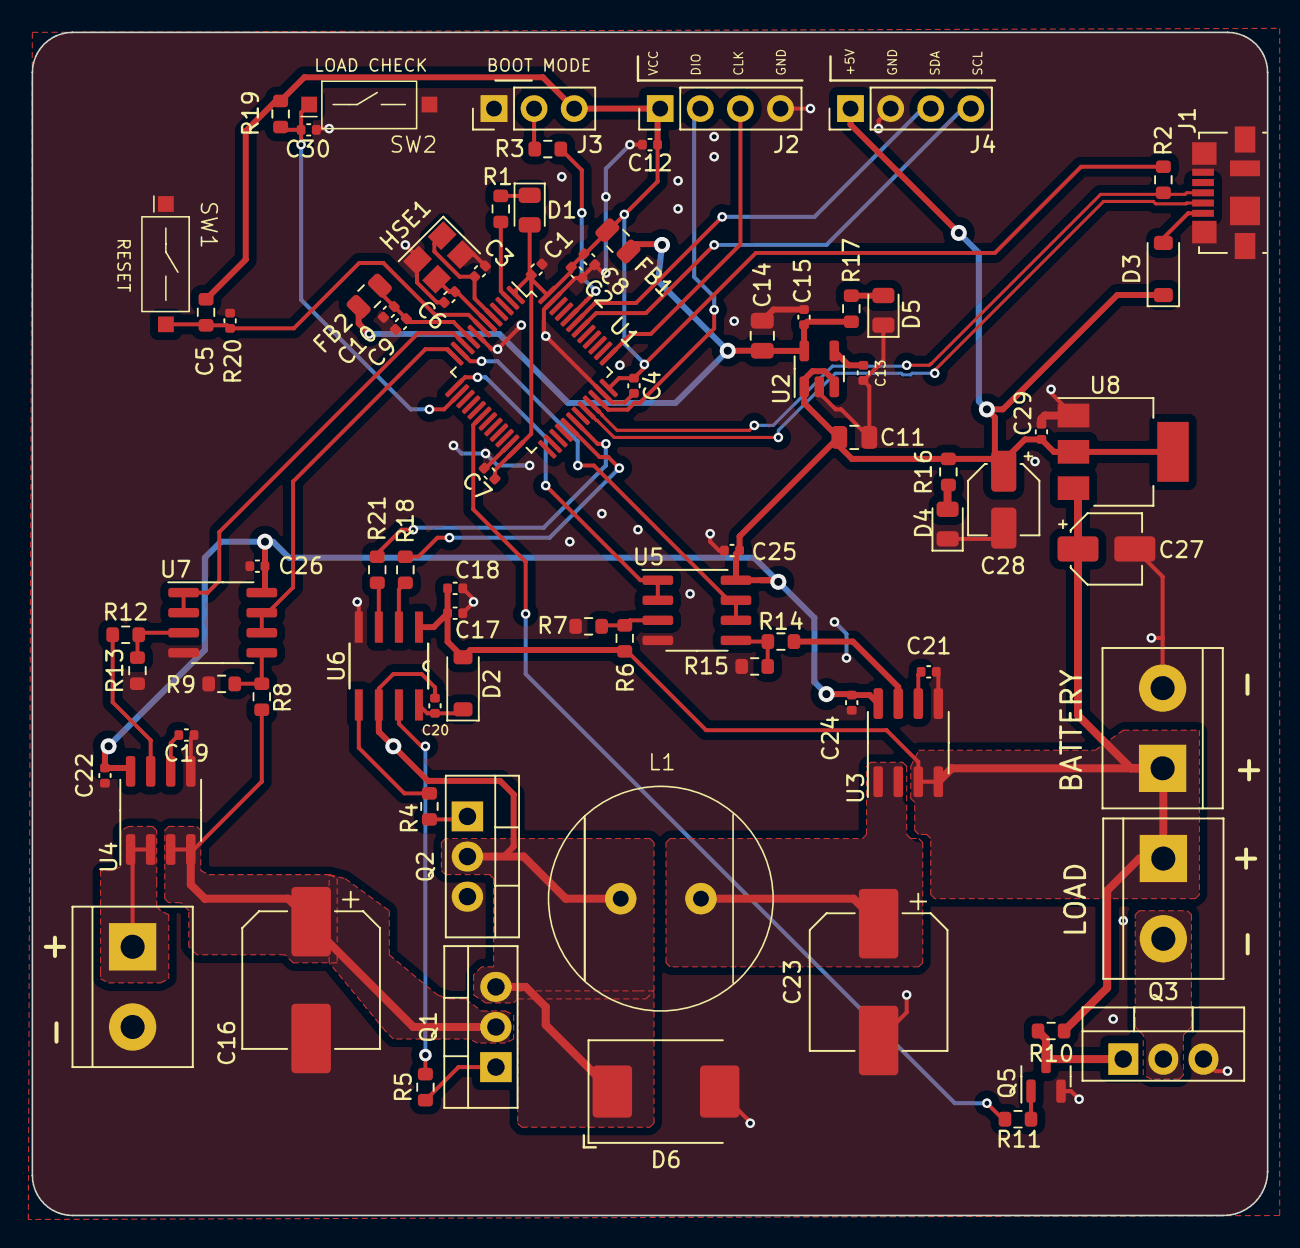
[picture p57: board Project232.kicad_pcb from above]

Board: 2 copper layers, 78.2 x 74.9 mm, 82 parts (0 on the bottom side), 53 nets.

Parts:
C1: 4.7uF; C_0402_1005Metric
C2, C4, C7, C8, C9, C12, C18, C22, C24, C25, C26, C30: 100nF; C_0402_1005Metric
C3, C6: 15pF; C_0402_1005Metric
C5: 4.7nF; C_0402_1005Metric
C10: 1uF; C_0402_1005Metric
C11: 10uF/16V; C_0805_2012Metric
C13, C15, C29: 0.1uF; C_0402_1005Metric
C14: 22uF/16V; C_0805_2012Metric
C16, C23: 100uF/50V; CP_Elec_8x10.5
C17, C20: 10uF; C_0402_1005Metric
C19, C21: 1nF; C_0402_1005Metric
C27: 10uF/16V; CP_Elec_4x5.4
C28: 22uF/16V; CP_Elec_4x5.4
D1: RED_LED; LED_0805_2012Metric
D2: 1N5819W; D_SOD-123
D3: B120-E3; D_SOD-123
D4, D5: LED; LED_0805_2012Metric
D6: 40V/5A; D_SMC
FB1, FB2: 0805; C_0805_2012Metric
HSE1: 8MHz; Crystal_SMD_3225-4Pin_3.2x2.5mm
J1: USB_B_Micro; USB_Micro-B_Molex_47346-0001
J2: SPI CONNECTOR; PinHeader_1x04_P2.54mm_Vertical
J3: BOOT MODE; PinHeader_1x03_P2.54mm_Vertical
J4: LCD_CONNECTOR; PinHeader_1x04_P2.54mm_Vertical
L1: 33uH; Inductor_33uH_5A_THT
Q1, Q2, Q3: IRF3205; TO-220-3_Vertical
Q5: SOT-23
R1: 150R; R_0603_1608Metric
R2: 4k7; R_0603_1608Metric
R3, R6, R8, R10, R20: 10k; R_0603_1608Metric
R4, R5: 10R; R_0603_1608Metric
R7, R9, R13, R15: 2k2; R_0603_1608Metric
R11, R16, R17, R19: 1k; R_0603_1608Metric
R12, R14: 3k3; R_0603_1608Metric
R18, R21: 470R; R_0603_1608Metric
SW1: RESET; Button_3x6_SMD
SW2: LOAD_CHECK_BUTTON; Button_3x6_SMD
TER1: SOLAR_PN; TerminalBlock_bornier-2_P5.08mm
TER2: BATT; TerminalBlock_bornier-2_P5.08mm
TER3: DC_LOAD; TerminalBlock_bornier-2_P5.08mm
U1: STM32F103C8T6; LQFP-48_7x7mm_P0.5mm
U2: MIC5205-3.3YM5; SOT-23-5
U3, U4: ACS712; SOIC-8_3.9x4.9mm_P1.27mm
U5, U7: LM358; SOIC-8_3.9x4.9mm_P1.27mm
U6: IR2104SPBF; SOIC127P600X175-8N
U8: AMS1117-5.0; SOT-223-3_TabPin2

Connections:
+5V: C11.1, C22.1, C24.1, C25.1, C26.1, C28.1, C29.1, D3.1 (K), J4.1, R16.1, U2.1 (IN), U2.3 (EN), U3.8 (VCC), U4.8 (VCC), U5.8 (V+), U7.8 (V+), U8.2 (VO)
+BATT: C17.1, C18.1, C27.1, D2.2 (A), R6.1, R10.1, TER2.1, TER3.1, U3.3 (IP-), U3.4 (IP-), U6.1 (VCC), U8.3 (VI)
/MCU/BOOT0: R3.2, U1.44 (BOOT0)
/MCU/BUCK_EN: R21.2, U1.30 (PA9)
/MCU/CURR_IN: U1.10 (PA0), U7.1, U7.2 (-)
/MCU/CURR_OUT: U1.11 (PA1), U5.6 (-), U5.7
/MCU/DEBUG_LED: R1.1, U1.2 (PC13)
/MCU/HSE_IN: C3.1, HSE1.1, U1.5 (PD0)
/MCU/HSE_OUT: C6.1, HSE1.3, U1.6 (PD1)
/MCU/LCD_SCL: J4.4, U1.42 (PB6)
/MCU/LCD_SDA: J4.3, U1.43 (PB7)
/MCU/LOAD_CHECK: C30.1, R19.2, SW2.1, U1.14 (PA4)
/MCU/LOAD_CTR: R11.1, U1.18 (PB0)
/MCU/NRST: C5.1, R20.1, SW1.2, U1.7 (NRST)
/MCU/PWM_PIN: R18.2, U1.29 (PA8)
/MCU/SWCLK: J2.3, U1.37 (PA14)
/MCU/SWDIO: J2.2, U1.34 (PA13)
/MCU/USB+: J1.3 (D+), R2.2, U1.33 (PA12)
/MCU/USB-: J1.2 (D-), U1.32 (PA11)
/MCU/VADC_IN: U1.12 (PA2), U7.6 (-), U7.7
/MCU/VADC_OUT: U1.13 (PA3), U5.1, U5.2 (-)
/Sens/-LOAD: Q3.2 (D), TER3.2
/Sens/CURR_IN_SENS: R12.1, U4.7 (VIOUT)
/Sens/CURR_OUT_SENS: R14.1, U3.7 (VIOUT)
/Sens/PANEL_IN: TER1.1, U4.1 (IP+), U4.2 (IP+)
/Sens/Q1_Q2_COM: C20.2, D6.1 (K), L1.1, Q1.3 (S), Q2.2 (D), U6.6 (VS)
/Sens/VIN: C16.1, Q1.2 (D), R8.1, U4.3 (IP-), U4.4 (IP-)
/Sens/VOL_IN: R8.2, R9.1, U7.5 (+)
/Sens/VOL_OUT: R6.2, R7.1, U5.3 (+)
/Sens/VOUT: C23.1, L1.2, U3.1 (IP+), U3.2 (IP+)
GND: C1.2, C2.2, C3.2, C4.2, C5.2, C6.2, C7.2, C8.2, C9.2, C10.2, C11.2, C12.2, C13.2, C14.2, C15.2, C16.2, C17.2, C18.2, C19.1, C21.1, C22.2, C23.2, C24.2, C25.2, C26.2, C27.2, C28.2, C29.2, C30.2, D4.1 (K), D5.1 (K), D6.2 (A), HSE1.2, HSE1.4, J1.5 (GND), J1.6 (Shield), J2.4, J3.1, J4.2, Q2.3 (S), Q3.3 (S), Q5.2 (E), R7.2, R9.2, R13.1, R15.1, SW1.1, SW2.2, TER1.2, TER2.2, U1.8 (VSSA), U1.23 (VSS), U1.35 (VSS), U1.47 (VSS), U2.2 (GND), U3.5 (GND), U4.5 (GND), U5.4 (V-), U6.4 (COM), U7.4 (V-), U8.1 (GND)
unnamed: D1.1 (K), R1.2
unnamed: C20.1, D2.1 (K), U6.8 (VB)
unnamed: D3.2 (A), J1.1 (VBUS)
unnamed: D4.2 (A), R16.2
unnamed: D5.2 (A), R17.2
unnamed: J3.2, R3.1
unnamed: Q1.1 (G), R5.2
unnamed: Q2.1 (G), R4.2
unnamed: Q3.1 (G), Q5.3 (C), R10.2
unnamed: Q5.1 (B), R11.2
unnamed: C13.1, U2.4 (BP)
unnamed: C14.1, C15.1, FB1.2, FB2.2, R17.1, U2.5 (OUT)
unnamed: C21.2, U3.6 (FILTER)
unnamed: C19.2, U4.6 (FILTER)
unnamed: R14.2, R15.2, U5.5 (+)
unnamed: R5.1, U6.7 (HO)
unnamed: R18.1, U6.2 (IN)
unnamed: R4.1, U6.5 (LO)
unnamed: R21.1, U6.3 (~SD)
unnamed: R12.2, R13.2, U7.3 (+)
VCC: C1.1, C2.1, C4.1, C7.1, C8.1, C12.1, D1.2 (A), FB1.1, J2.1, J3.3, R2.1, R19.1, R20.2, U1.1 (VBAT), U1.24 (VDD), U1.36 (VDD), U1.48 (VDD)
VDDA: C9.1, C10.1, FB2.1, U1.9 (VDDA)
