quochuymao/project232/project_rfs/MPPT 10A/EAGLE FILE.brd

## EAGLE design project_rfs/MPPT 10A/EAGLE FILE.brd (2024-04-10)

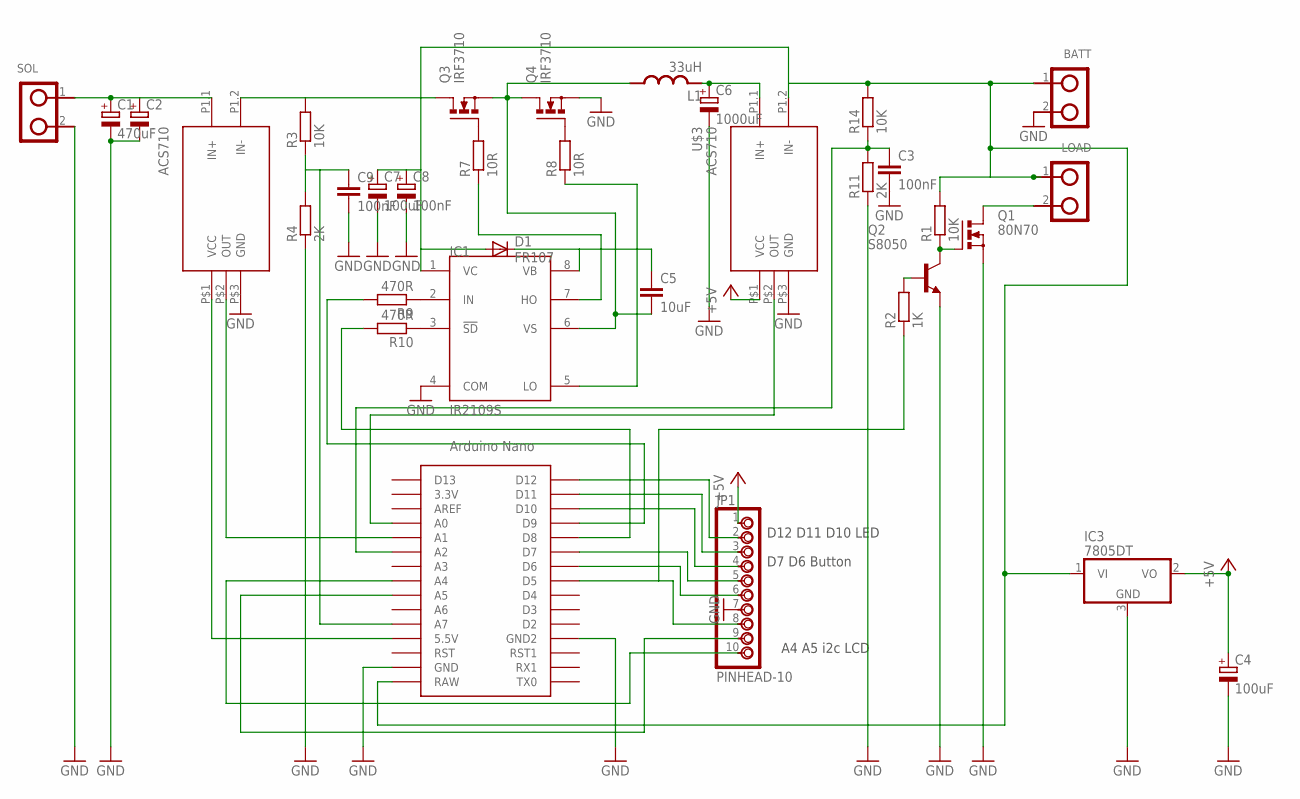
[picture p58: schematic EAGLE FILE.sch]

Parts:
.: ACS710; CURRENT-SENSOR-ACS712#IC
BATT: DOMINO-2; DOMI-2
C1: 470uF; E5-13
C2: CPOL-EUE5-13; E5-13
C3, C9: 100nF; C1206
C4, C7: 100uF; SMC_D
C5: 10uF; C1812
C6: 1000uF; E5-13
C8: 100nF; SMC_D
D1: FR107; SMB
IC1: IR2109S; SO08
IC3: 7805DT; TO252
JP1: PINHEAD-10
L1: 33uH; L-10
LOAD: DOMINO-2; DOMI-2
Q1: 80N70; TO220BV
Q2: S8050; TO92
Q3, Q4: IRF3710; TO220BV
R1, R3, R14: 10K; R1206
R2: 1K; R1206
R4, R11: 2K; R1206
R7, R8: 10R; R1206
R9, R10: 470R; R1206
SOL: DOMINO-2; DOMI-2
U$1: NANO
U$3: ACS710; CURRENT-SENSOR-ACS712#IC

Connections:
+5V: C4.+, IC3.2 (VO), JP1.1, U$3.P$1 (VCC)
GND: ..P$3 (GND), BATT.2, C1.-, C2.-, C3.2, C4.-, C6.-, C7.-, C8.-, C9.2, IC1.4 (COM), IC3.3 (GND), JP1.7, Q1.S, Q2.3 (E), Q4.S, R4.1, R11.1, SOL.2, U$1.GND, U$1.GND1 (GND2), U$3.P$3 (GND)
unnamed: ..P$1 (VCC), U$1.5V (5.5V)
unnamed: LOAD.2, Q1.D
unnamed: Q1.G, Q2.1 (C), R1.1
unnamed: Q2.2 (B), R2.2
unnamed: JP1.8, R2.1, U$1.D5
unnamed: ..P1.1 (IN+), C1.+, C2.+, SOL.1
unnamed: ..P1.2 (IN-), Q3.D, R3.2
unnamed: ..P$2 (OUT), U$1.A1
unnamed: C9.1, R3.1, R4.2, U$1.A7
unnamed: JP1.5, U$1.D7
unnamed: JP1.6, U$1.D6
unnamed: JP1.2, U$1.D12
unnamed: JP1.3, U$1.D11
unnamed: JP1.4, U$1.D10
unnamed: Q3.G, R7.2
unnamed: Q4.G, R8.2
unnamed: IC1.7 (HO), R7.1
unnamed: IC1.5 (LO), R8.1
unnamed: IC1.2 (IN), R9.1
unnamed: IC1.3 (!SD), R10.1
unnamed: R9.2, U$1.D9
unnamed: R10.2, U$1.D8
unnamed: U$1.A0, U$3.P$2 (OUT)
unnamed: C3.1, R11.2, R14.1, U$1.A2
unnamed: C6.+, L1.2, U$3.P1.1 (IN+)
unnamed: JP1.10, U$1.A4
unnamed: JP1.9, U$1.A5
VB: C5.1, D1.C, IC1.8 (VB)
VCCS: BATT.1, C7.+, C8.+, D1.A, IC1.1 (VC), IC3.1 (VI), LOAD.1, R1.2, R14.2, U$1.RAW, U$3.P1.2 (IN-)
VS: C5.2, IC1.6 (VS), L1.1, Q3.S, Q4.D

Notes on the sheet:
D12 D11 D10 LED
D7 D6 Button
A4 A5 i2c LCD

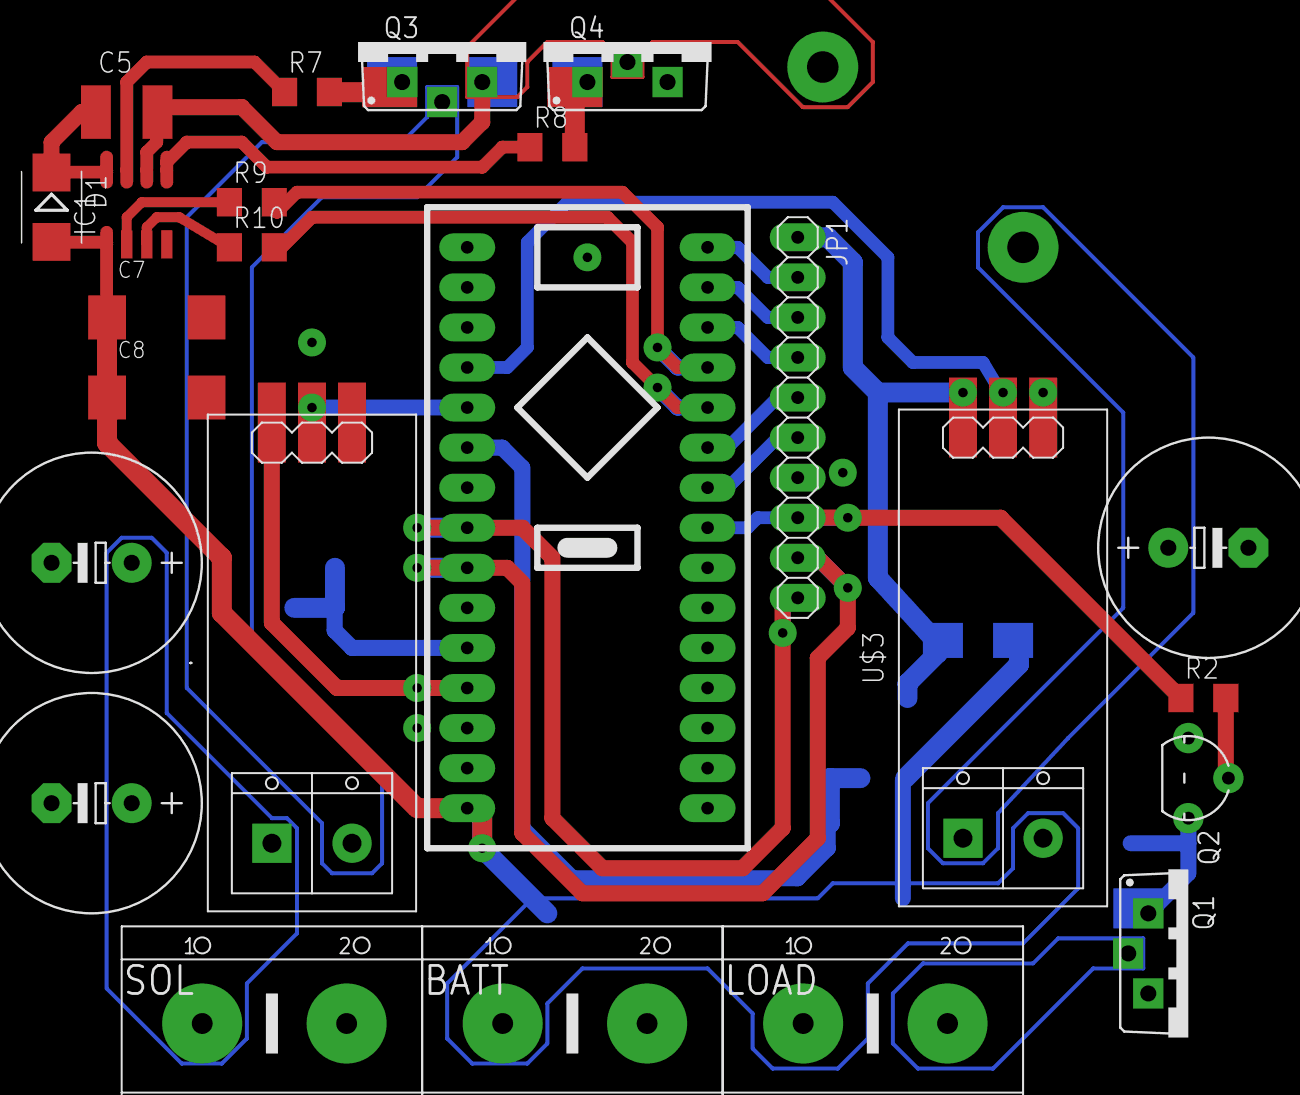
[picture p59: board EAGLE FILE.brd from above]

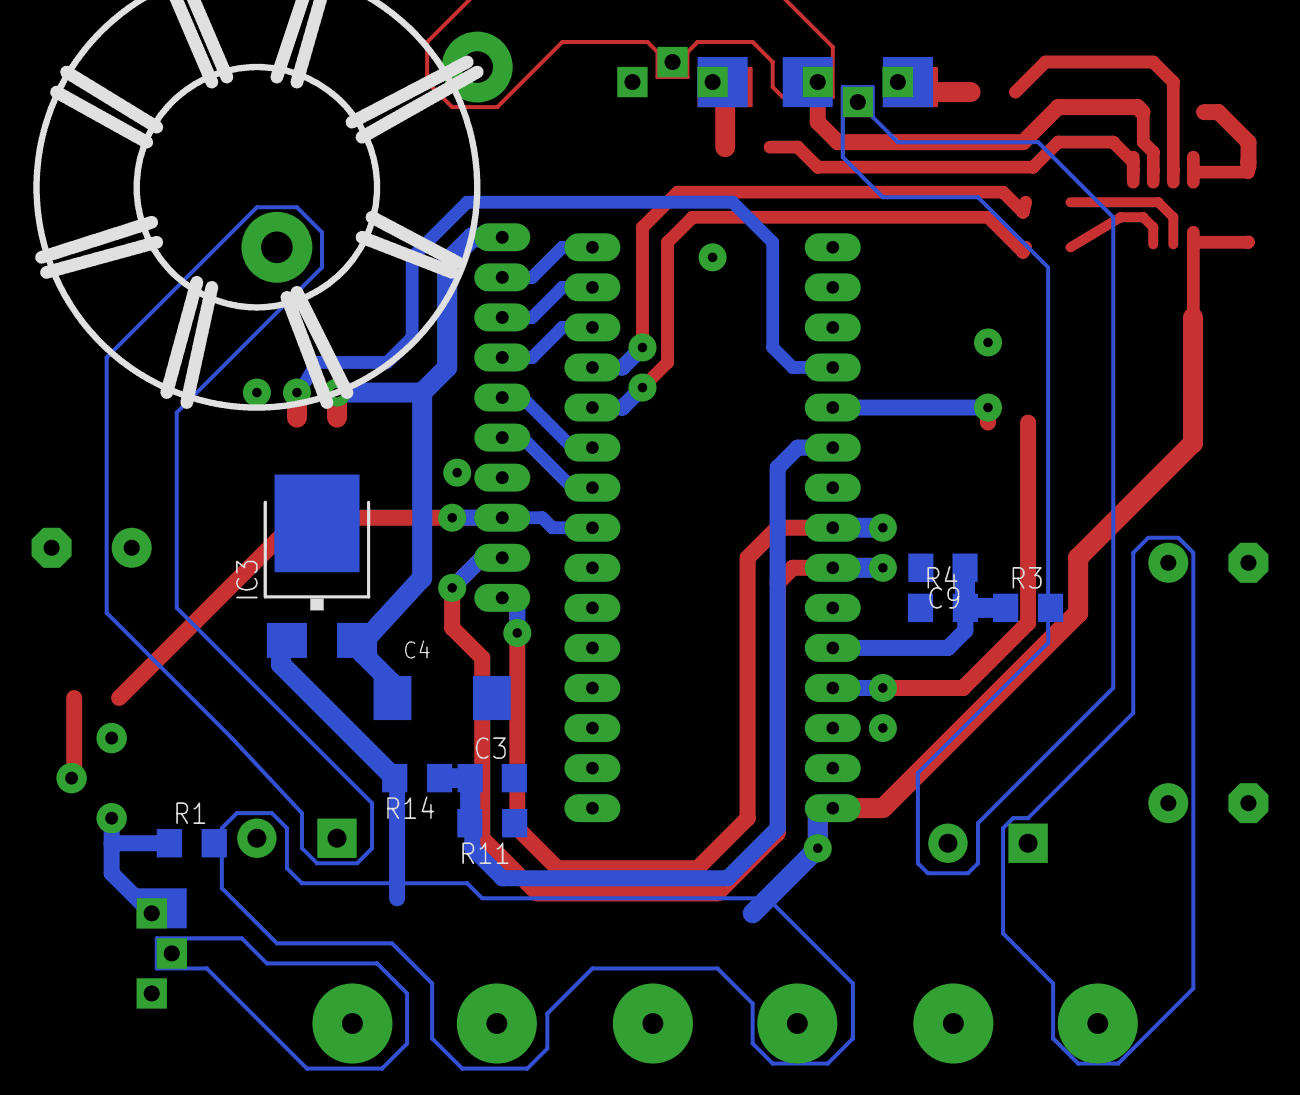
[picture p60: board EAGLE FILE.brd from below]

Board: 2 copper layers, 34 parts (10 on the bottom side), 32 nets.
