quochuymao/project232/firmware/Core/Inc/main.h

#define TEST_Pin GPIO_PIN_13
#define TEST_GPIO_Port GPIOC
#define CURRENT_IN_Pin GPIO_PIN_0
#define CURRENT_IN_GPIO_Port GPIOA
#define CURRENT_OUT_Pin GPIO_PIN_1
#define CURRENT_OUT_GPIO_Port GPIOA
#define VOLTAGE_IN_Pin GPIO_PIN_2
#define VOLTAGE_IN_GPIO_Port GPIOA
#define VOLTAGE_OUT_Pin GPIO_PIN_3
#define VOLTAGE_OUT_GPIO_Port GPIOA
#define CHANGE_DISPLAY_Pin GPIO_PIN_4
#define CHANGE_DISPLAY_GPIO_Port GPIOA
#define CHANGE_DISPLAY_EXTI_IRQn EXTI4_IRQn
#define LOAD_CTR_Pin GPIO_PIN_0
#define LOAD_CTR_GPIO_Port GPIOB
#define PWM_OUT_Pin GPIO_PIN_8
#define PWM_OUT_GPIO_Port GPIOA
#define BUCK_EN_Pin GPIO_PIN_9
#define BUCK_EN_GPIO_Port GPIOA
#define ENABLE_CONTROL 1
#define DISABLE_CONTROL 0
