quochuymao/project232/firmware/Core/Src/main.c

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
/* Includes ------------------------------------------------------------------*/
#include "main.h"

/* USER CODE BEGIN PTD */
state_display display = POWER_DISPLAY;
/* USER CODE END PTD */

ADC_HandleTypeDef hadc1;
DMA_HandleTypeDef hdma_adc1;

I2C_HandleTypeDef hi2c1;

TIM_HandleTypeDef htim1;

PCD_HandleTypeDef hpcd_USB_FS;

void SystemClock_Config(void);
static void MX_GPIO_Init(void);
static void MX_DMA_Init(void);
static void MX_ADC1_Init(void);
static void MX_I2C1_Init(void);
static void MX_TIM1_Init(void);
static void MX_USB_PCD_Init(void);
/* USER CODE BEGIN PFP */
void HAL_GPIO_EXTI_Callback(uint16_t GPIO_Pin);
/* USER CODE END PFP */

/* USER CODE BEGIN 0 */
uint32_t adc_value[2];
uint8_t dutyCycle = 70;
float currentOut,currentIn,voltageIn,voltageOut;
float Power_Out_Previous = 0,Power_Out_Current = 0;
float Power_In_Current = 0;
  /* NOTE : This function should not be modified. When the callback is needed,
            function HAL_ADC_ConvCpltCallback must be implemented in the user file.
   */
/* USER CODE END 0 */

/**
  * @brief  The application entry point.
  * @retval int
  */
int main(void)
{
  /* MCU Configuration--------------------------------------------------------*/

  /* Reset of all peripherals, Initializes the Flash interface and the Systick. */
  HAL_Init();

  /* Configure the system clock */
  SystemClock_Config();

  /* Initialize all configured peripherals */
  MX_GPIO_Init();
  MX_DMA_Init();
  MX_ADC1_Init();
  MX_I2C1_Init();
  MX_TIM1_Init();
  MX_USB_PCD_Init();
  /* USER CODE BEGIN 2 */
  lcd_init();
  lcd_clear_display();
  PWM_Control(dutyCycle,100000);
  PWM_Enable();

  //PWM_Control(50, 1);

  /* USER CODE END 2 */

  /* Infinite loop */
  /* USER CODE BEGIN WHILE */
  while (1)
  {
    /* USER CODE END WHILE */

    /* USER CODE BEGIN 3 */


	  loadControl(0);
	  HAL_ADC_Start_DMA(&hadc1,adc_value, 2);
	 // currentIn = getCurrentIn(adc_value[0]);
	  //currentOut = ((float)adc_value[1]/4096)*3.3;
	  voltageIn =  ((float)adc_value[0]/4096)*3.3*5.68;
	  voltageOut = ((float)adc_value[1]/4096)*3.3*5.68;
	  if(voltageOut <2)
	  {
		  voltageOut = 0;
	  }
	  if(voltageIn < 2)
	  {
		  voltageIn = 0;
	  }
	  Power_Out_Current = voltageOut * currentOut;
	  Power_In_Current = voltageIn * currentIn;

	  int Voltage_Out_N = voltageOut/1;
	  int Voltage_Out_T = ((voltageOut - Voltage_Out_N)*100)/1;
	  int Voltage_In_N = voltageIn/1;
	  int Voltage_In_T = ((voltageIn - Voltage_In_N)*100)/1;

	  /*
	  int Power_Out_Current_N = Power_Out_Current/1;
	  int Power_Out_Current_T = ((Power_Out_Current - Power_Out_Current_N)*100)/1;
	  int Power_In_Current_N = Power_In_Current/1;
	  int Power_In_Current_T = ((Power_In_Current - Power_In_Current_T)*100)/1;

	  if(Power_Out_Current > Power_Out_Previous)
	  {
		  dutyCycle = dutyCycle + 1;
	  }
	  else
	  {
		  dutyCycle = dutyCycle - 1;
	  }
	  */

	  Power_Out_Previous = Power_Out_Current;
	  PWM_Control(dutyCycle, 100000);

	  lcd_display(Voltage_In_N,Voltage_In_T,Voltage_Out_N,Voltage_Out_T);
	  HAL_Delay(1000);
	  if(voltageIn >= 15 && voltageIn <=18.5)
	  {
		  buckControl(1);
	  }
	  else
	  {
		  buckControl(0);
	  }
  }
  /* USER CODE END 3 */
}

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
/* USER CODE BEGIN 4 */
void HAL_GPIO_EXTI_Callback(uint16_t GPIO_Pin)
{
	if(GPIO_Pin == CHANGE_DISPLAY_Pin)
	{
		switch(display)
		{
		case POWER_DISPLAY:
			display= STATUS_SYSTEM;
		break;
		case STATUS_SYSTEM:
			display= VOL_DISPLAY;
		break;
		case VOL_DISPLAY:
			display= CURR_DISPLAY;
		break;
		case CURR_DISPLAY:
			display= POWER_DISPLAY;
		break;
		default: break;
		}
	} else
	{
		__NOP();
	}

}
/* USER CODE END 4 */
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
