quochuymao/project232/firmware/Core/LCD_I2C/LCD.c

#include "LCD.h"
extern I2C_HandleTypeDef hi2c1;  // change your handler here accordingly

#define SLAVE_ADDRESS_LCD 0x4E // change this according to ur setup


void lcd_send_cmd (char cmd)
{
  char data_u, data_l;
	uint8_t data_t[4];
	data_u = (cmd&0xf0);
	data_l = ((cmd<<4)&0xf0);
	data_t[0] = data_u|0x0C;  //en=1, rs=0
	data_t[1] = data_u|0x08;  //en=0, rs=0
	data_t[2] = data_l|0x0C;  //en=1, rs=0
	data_t[3] = data_l|0x08;  //en=0, rs=0
	HAL_I2C_Master_Transmit (&hi2c1, SLAVE_ADDRESS_LCD,(uint8_t *) data_t, 4, 100);
}

void lcd_send_data (char data)
{
	char data_u, data_l;
	uint8_t data_t[4];
	data_u = (data&0xf0);
	data_l = ((data<<4)&0xf0);
	data_t[0] = data_u|0x0D;  //en=1, rs=0
	data_t[1] = data_u|0x09;  //en=0, rs=0
	data_t[2] = data_l|0x0D;  //en=1, rs=0
	data_t[3] = data_l|0x09;  //en=0, rs=0
	HAL_I2C_Master_Transmit (&hi2c1, SLAVE_ADDRESS_LCD,(uint8_t *) data_t, 4, 100);
}

void lcd_init (void)
{
	lcd_send_cmd (0x33); /* set 4-bits interface */
	lcd_send_cmd (0x32);
	HAL_Delay(50);
	lcd_send_cmd (0x28); /* start to set LCD function */
	HAL_Delay(50);
	lcd_send_cmd (0x01); /* clear display */
	HAL_Delay(50);
	lcd_send_cmd (0x06); /* set entry mode */
	HAL_Delay(50);
	lcd_send_cmd (0x0c); /* set display to on */
	HAL_Delay(50);
	lcd_send_cmd (0x02); /* move cursor to home and set data address to 0 */
	HAL_Delay(50);
	lcd_send_cmd (0x80);
}

void lcd_send_string (char *str)
{
	while (*str) lcd_send_data (*str++);
}

void lcd_clear_display (void)
{
	lcd_send_cmd (0x01); //clear display
}

void lcd_goto_XY (int row, int col)
{
	uint8_t pos_Addr;
	if(row == 1)
	{
		pos_Addr = 0x80 + row - 1 + col;
	}
	else
	{
		pos_Addr = 0x80 | (0x40 + col);
	}
	lcd_send_cmd(pos_Addr);
}
void lcd_display(int votageIn_N,int votageIn_T,int votageOut_N, int votageOut_T)
{
	char str[30];
	lcd_clear_display();
	switch(display)
	{
	case POWER_DISPLAY:
		lcd_goto_XY(1,0);
		HAL_Delay(10);
		lcd_send_string("Pin: ");
		HAL_Delay(10);
		sprintf(str,"%d.%d W",0,0);
		lcd_send_string(str);
		HAL_Delay(10);
		lcd_goto_XY(2,0);
		HAL_Delay(10);
		lcd_send_string("Pout: ");
		HAL_Delay(10);
		sprintf(str,"%d.%d W",0,0);
		lcd_send_string(str);
		break;
	case STATUS_SYSTEM:
		lcd_clear_display();
		lcd_goto_XY(1,1);
		HAL_Delay(10);
		lcd_send_string("BATTERY: --");
		HAL_Delay(10);
		lcd_goto_XY(2,0);
		HAL_Delay(10);
		lcd_send_string("LOAD: --");
		break;
	case VOL_DISPLAY:
		lcd_goto_XY(1,0);
		HAL_Delay(10);
		lcd_send_string("Vin: ");
		HAL_Delay(10);
		sprintf(str,"%d.%d V",votageIn_N,votageIn_T);
		lcd_send_string(str);
		HAL_Delay(10);
		lcd_goto_XY(2,0);
		HAL_Delay(10);
		lcd_send_string("Vout: ");
		HAL_Delay(10);
		sprintf(str,"%d.%d V",votageOut_N,votageOut_T);
		lcd_send_string(str);
		break;
	case CURR_DISPLAY:
		lcd_goto_XY(1,0);
		HAL_Delay(10);
		lcd_send_string("Curr_In: ");
		HAL_Delay(10);
		sprintf(str,"%d.%d A",0,0);
		lcd_send_string(str);
		HAL_Delay(10);
		lcd_goto_XY(2,0);
		HAL_Delay(10);
		lcd_send_string("Curr_Out: ");
		HAL_Delay(10);
		sprintf(str,"%d.%d A",0,0);
		lcd_send_string(str);
		break;
	default: break;
	}

}
