quochuymao/project232/(commit log)

2024-04-10 adding hardware file
    [EAGLE FILE.brd, EAGLE FILE.sch, Project232.kicad_pcb, Project232.kicad_sch, Sens.kicad_sch]
2024-04-19 update test board and docs
    [MCU.kicad_sch, Power.kicad_sch.kicad_sch, Project232.kicad_sch, Sens.kicad_sch, backup.kicad_sch, testboard.kicad_pcb, testboard.kicad_sch]
2024-04-22 update PIN in firmware
2024-05-08 Update PCB
    [LCD.kicad_sch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]
2024-05-08 update LCD and ADC function
2024-05-08 update GPIO, PWM function
2024-05-08 add API docs for STM32F103C8T6
2024-05-11 update gerber files
    [Project232.csv]
2024-05-11 fix PWM fucntion
2024-05-11 update PWM fucntion
2024-05-15 update PCB Board V2
    [MCU.kicad_sch, Project232_V2.kicad_pcb, Project232_V2.kicad_sch, sensor.kicad_sch]
2024-05-16 test PWM
2024-05-23 update flowchart for firmware
